GreenVaildSig/TallyNet_v1/README.md

# TallyNet_v1
Archive of my final exam piece TallyNet in version 1. This version contains many beginner errors and is not suitable for production. Hopfully all errors are eliminated in the new Version. All Texts are in German.
