GreenVaildSig/TallyNet_v1/Gehäuse/ne8fdy-c6-4.dxf

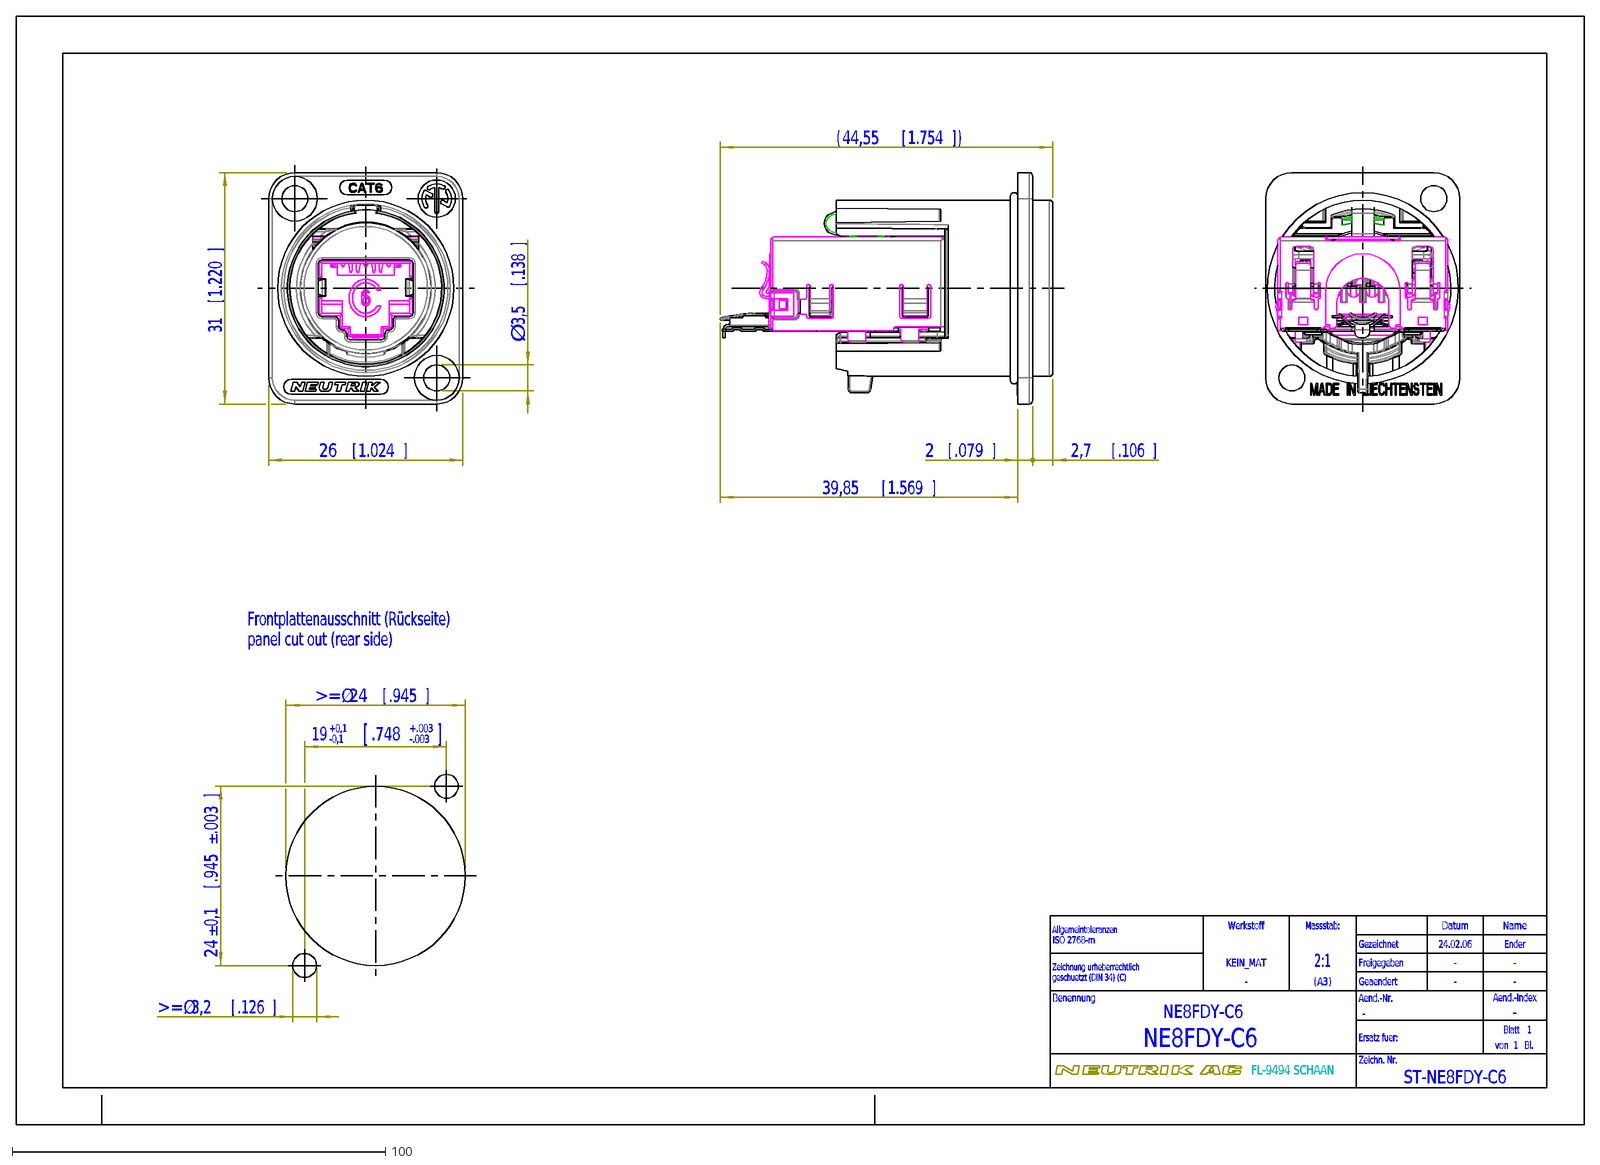
[picture p24: CAD file, 2022-08-05]
Gehäuse/ne8fdy-c6-4.dxf
FL-9494 SCHAAN
19
+0,1
-0,1
.748
+.003
-.003
[
]
24
±
0,1
.945
.003
>=Ø
3,2
.126
26
1.024
31
1.220
2,7
.106
2
.079
(
)
44,55
1.754
Ø
3,5
.138
39,85
1.569
Allgemeintoleranzen
ISO 2768-m
Werkstoff
Massstab:
Datum
Name
Gezeichnet
24.02.06
Ender
Zeichnung urheberrechtlich
geschuetzt (DIN 34) (C)
KEIN_MAT
2:1
Freigegeben
-
A3
Geaendert
Benennung
Aend.-Nr.
Aend.-Index
NE8FDY-C6
Ersatz fuer:
Blatt
1
von
Bl.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
