GreenVaildSig/TallyNet_v1/Gehäuse/nc3fdm3-l-1-4.dxf

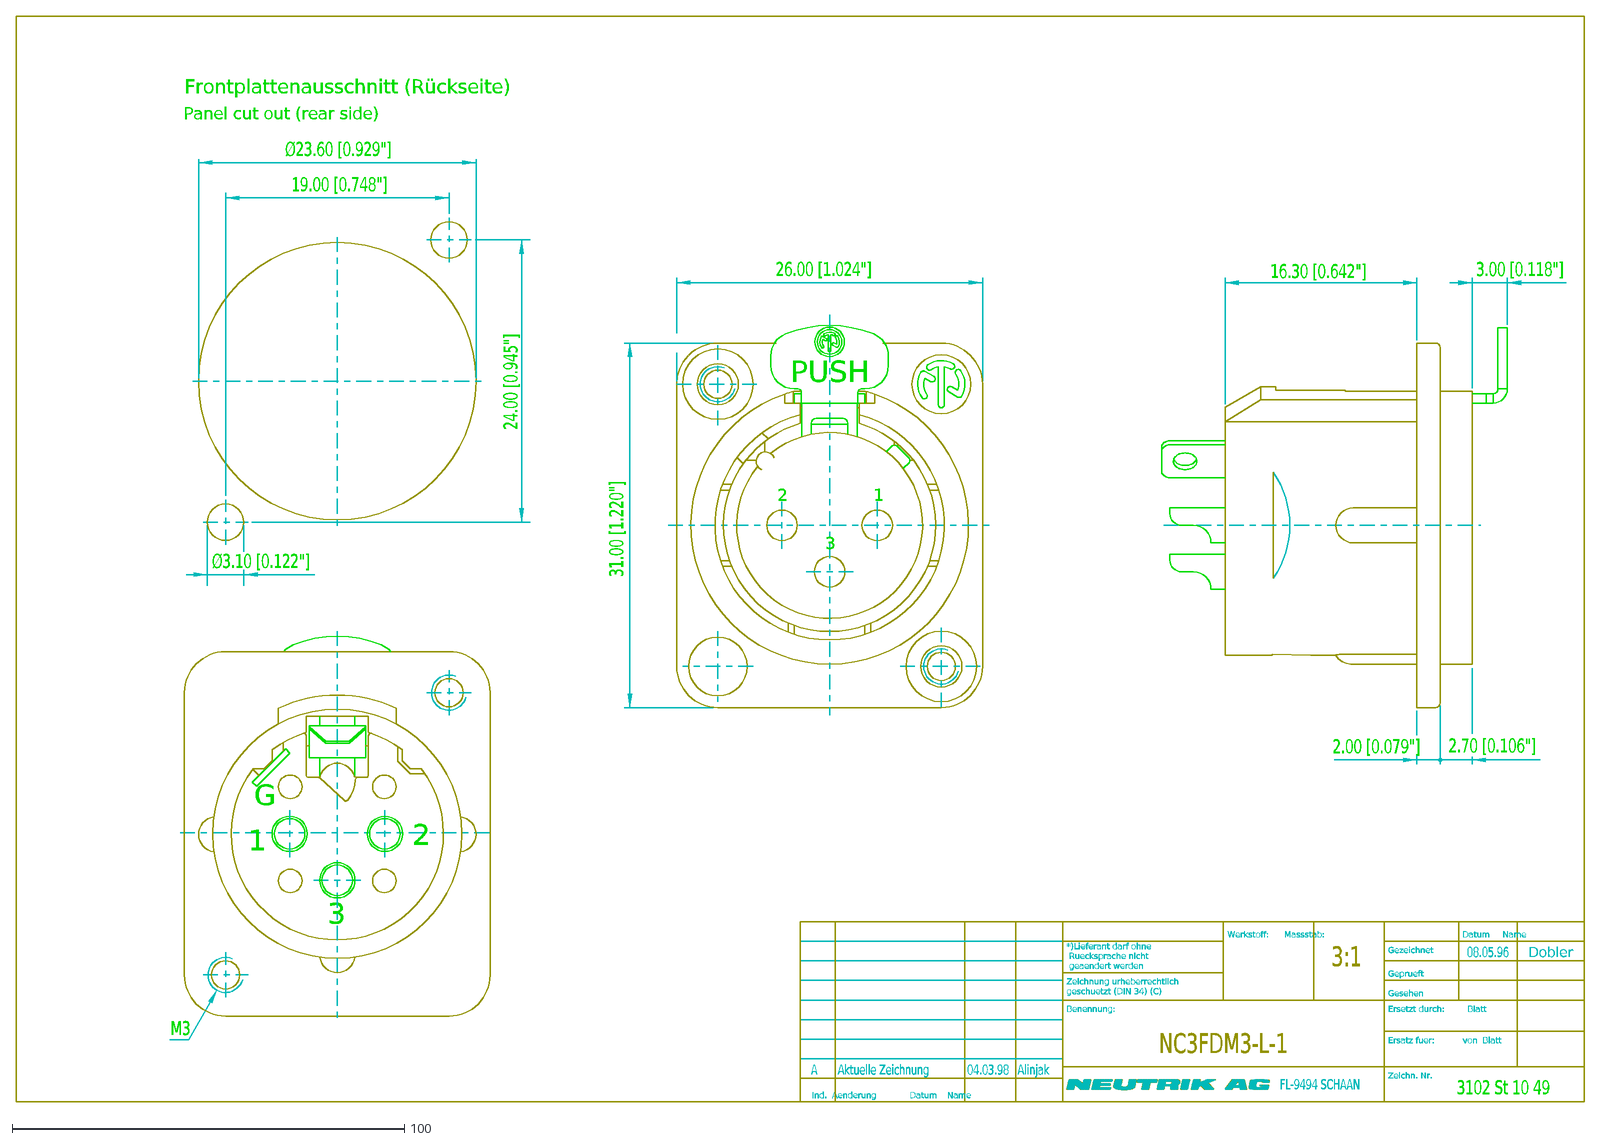
[picture p25: CAD file, 2022-08-05]
Gehäuse/nc3fdm3-l-1-4.dxf
PUSH
Dobler
08.05.96
NC3FDM3-L-1
3102 St 10 49
3:1
A
Aktuelle Zeichnung
04.03.98
Alinjak
Zeichn. Nr.
Ersetzt durch: Blatt
Gezeichnet
Gesehen
Datum Name
Werkstoff: Massstab:
Benennung:
*)Lieferant darf ohne
Ruecksprache nicht
geaendert werden
Zeichnung urheberrechtlich
geschuetzt (DIN 34) (C)
Geprueft
Ersatz fuer: von Blatt
Ind. Aenderung Datum Name
FL-9494 SCHAAN
26.00 [1.024"]
Ø3.10 [0.122"]
31.00 [1.220"]
M3
1
G
3
2
Frontplattenausschnitt (Rückseite)
Panel cut out (rear side)
24.00 [0.945"]
Ø23.60 [0.929"]
19.00 [0.748"]
2.00 [0.079"]
2.70 [0.106"]
16.30 [0.642"]
3.00 [0.118"]
