GreenVaildSig/TallyNet_v1/Gehäuse/#MuxFront.dxf

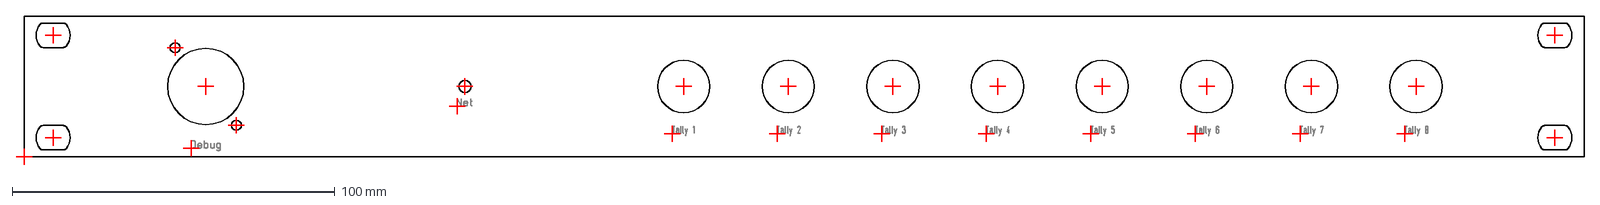
[picture p26: CAD file, 2022-08-05]
Gehäuse/#MuxFront.dxf
485.5 x 46.1 mm
