GreenVaildSig/TallyNet_v1/Gehäuse/#DeMuxFront.dxf

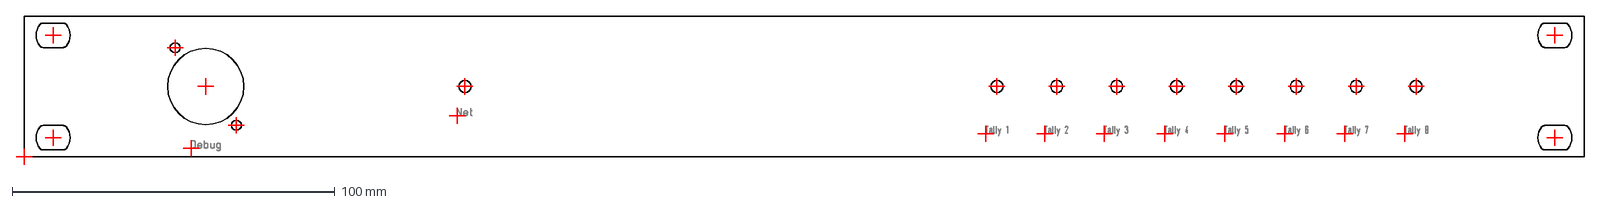
[picture p27: CAD file, 2022-08-05]
Gehäuse/#DeMuxFront.dxf
485.5 x 46.1 mm
