GreenVaildSig/TallyNet_v1/Gehäuse/#Back.dxf

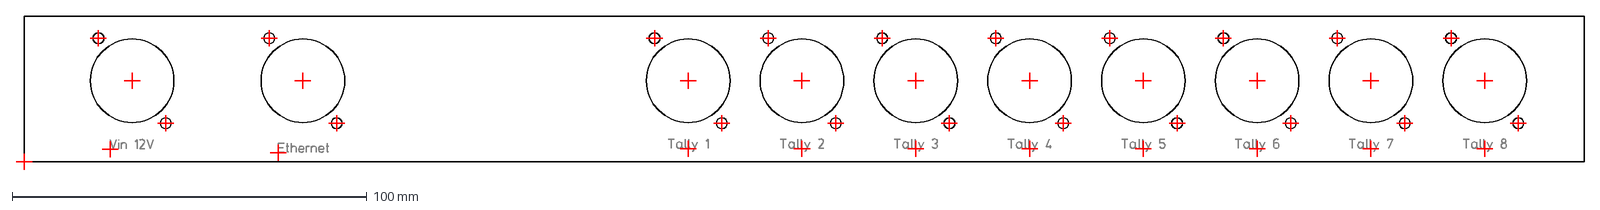
[picture p28: CAD file, 2022-08-05]
Gehäuse/#Back.dxf
442.3 x 43.3 mm
