GreenVaildSig/TallyNet_v1/(list of files, cad)

Other CAD files:
Gehäuse/Back.dxf
Gehäuse/DeMuxFront.dxf
Gehäuse/MuxFront.dxf
