GreenVaildSig/TallyNet_v1/02 Anlagen.pdf

J10 USB_B GND A¹ | RX2- A10 RX2+ A11 TX1+ A2 TX1- A3 VBUS | A4 CC1 A5 D+ A6 D- A7 SBU1 | A8 RX1- B10 RX1+ B11 TX2+ B2 TX2- B3 CC2 B5 D+ B6 D- B7 SBU2 | B8 SHIELD S¹
J7 XLR3 ¹ | 2 3 1 | 2 3

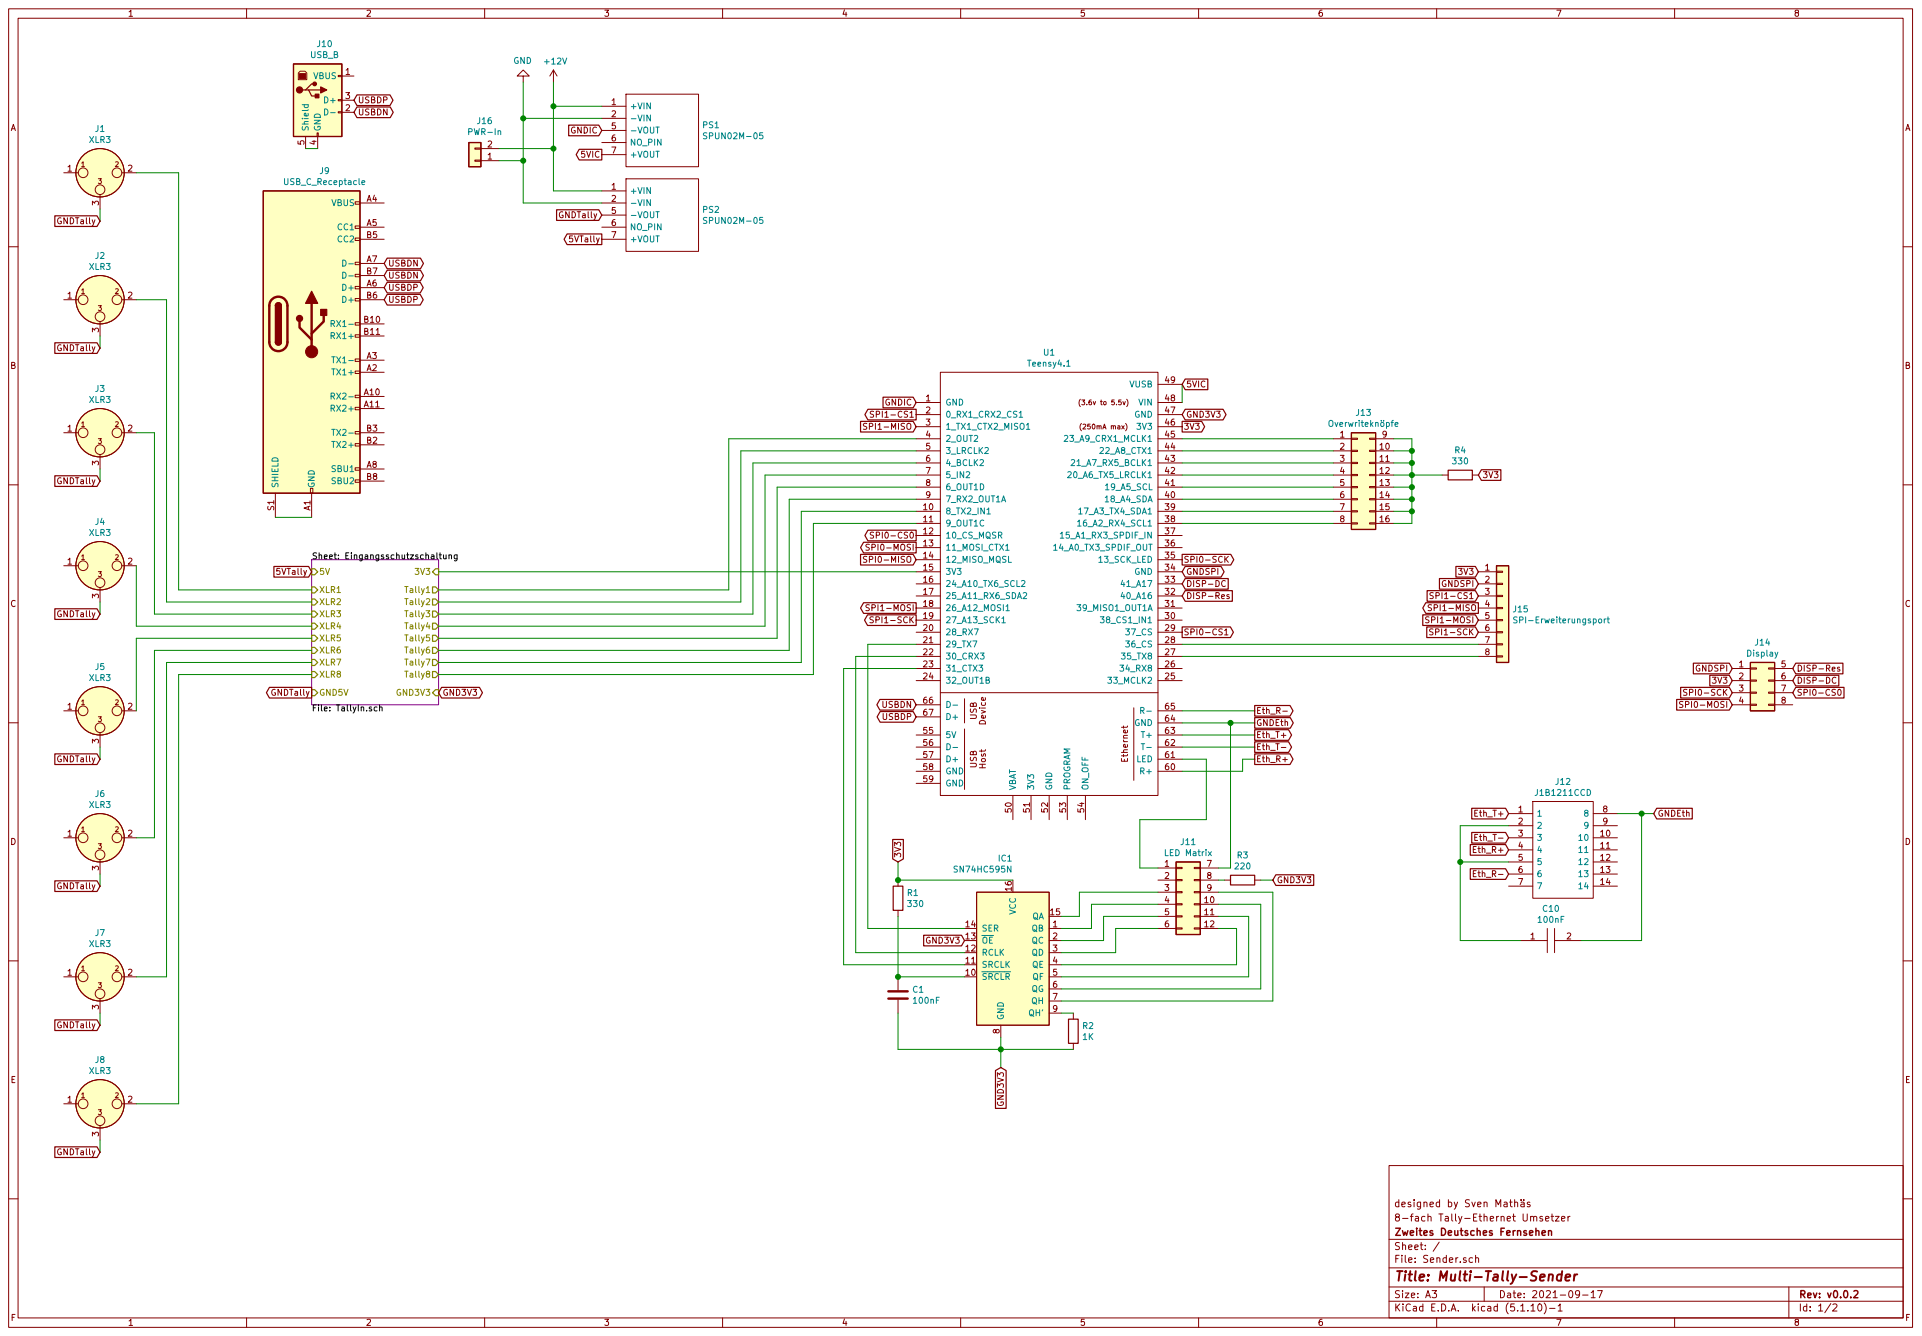
[picture p29: page 1]

designed by Sven Mathäs
8-fach Tally-Ethernet Umsetzer
Id: 1/2 Title: Multi-Tally-Sender File: Sender.sch Sheet: / Zweites Deutsches Fernsehen

Tally1 | GND⁵V GND⁵V | GND⁵V | GND⁵V GND⁵V | GND⁵V
XLR5 | GND⁵V GND⁵V GND⁵V

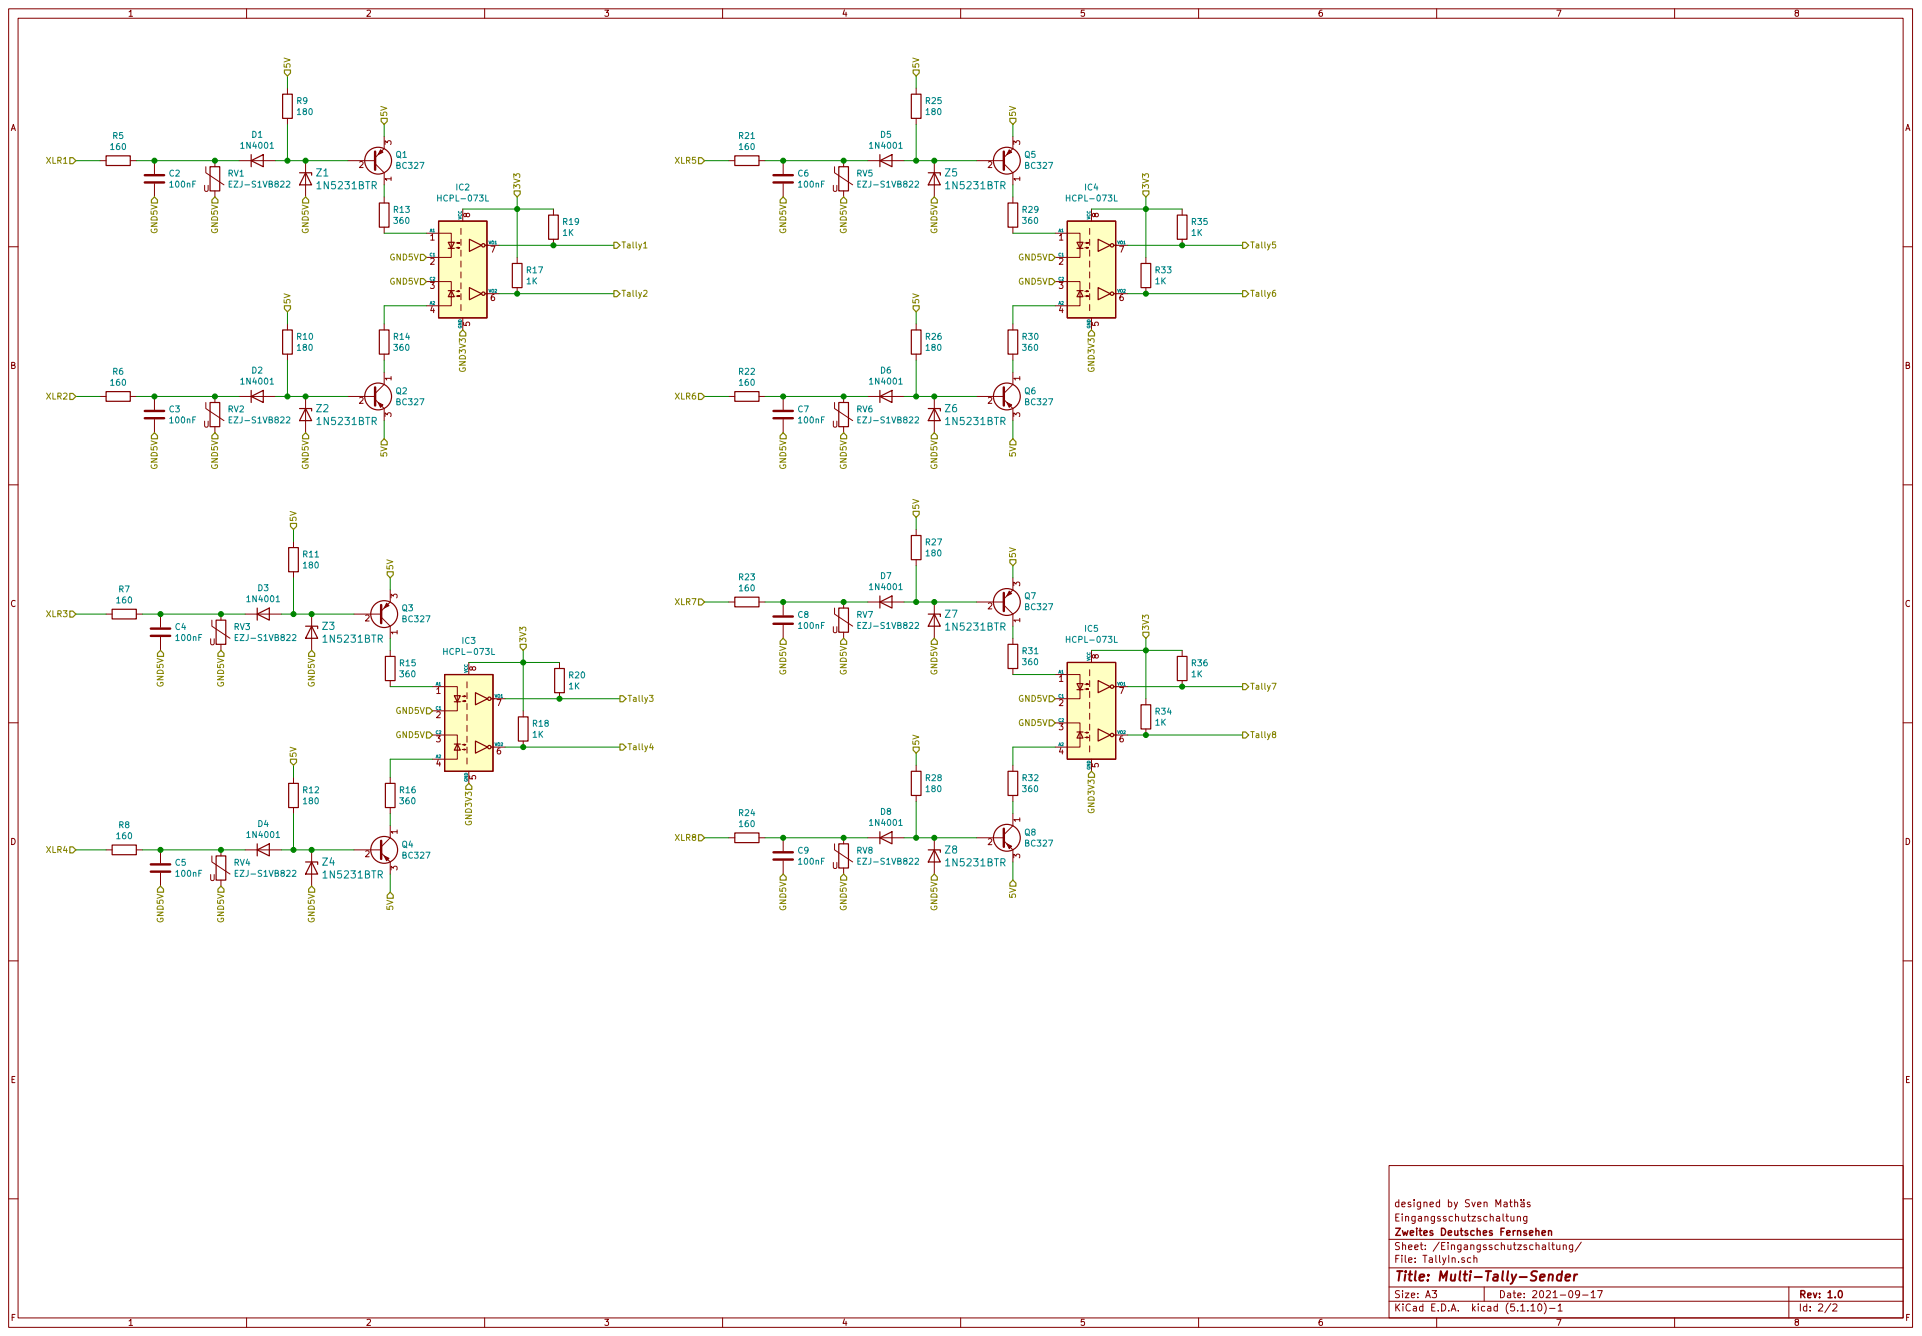
[picture p30: page 2]

designed by Sven Mathäs
Sheet: /Eingangsschutzschaltung/ Zweites Deutsches Fernsehen Eingangsschutzschaltung

File: TallyIn.sch
Id: 2/2 Title: Multi-Tally-Sender

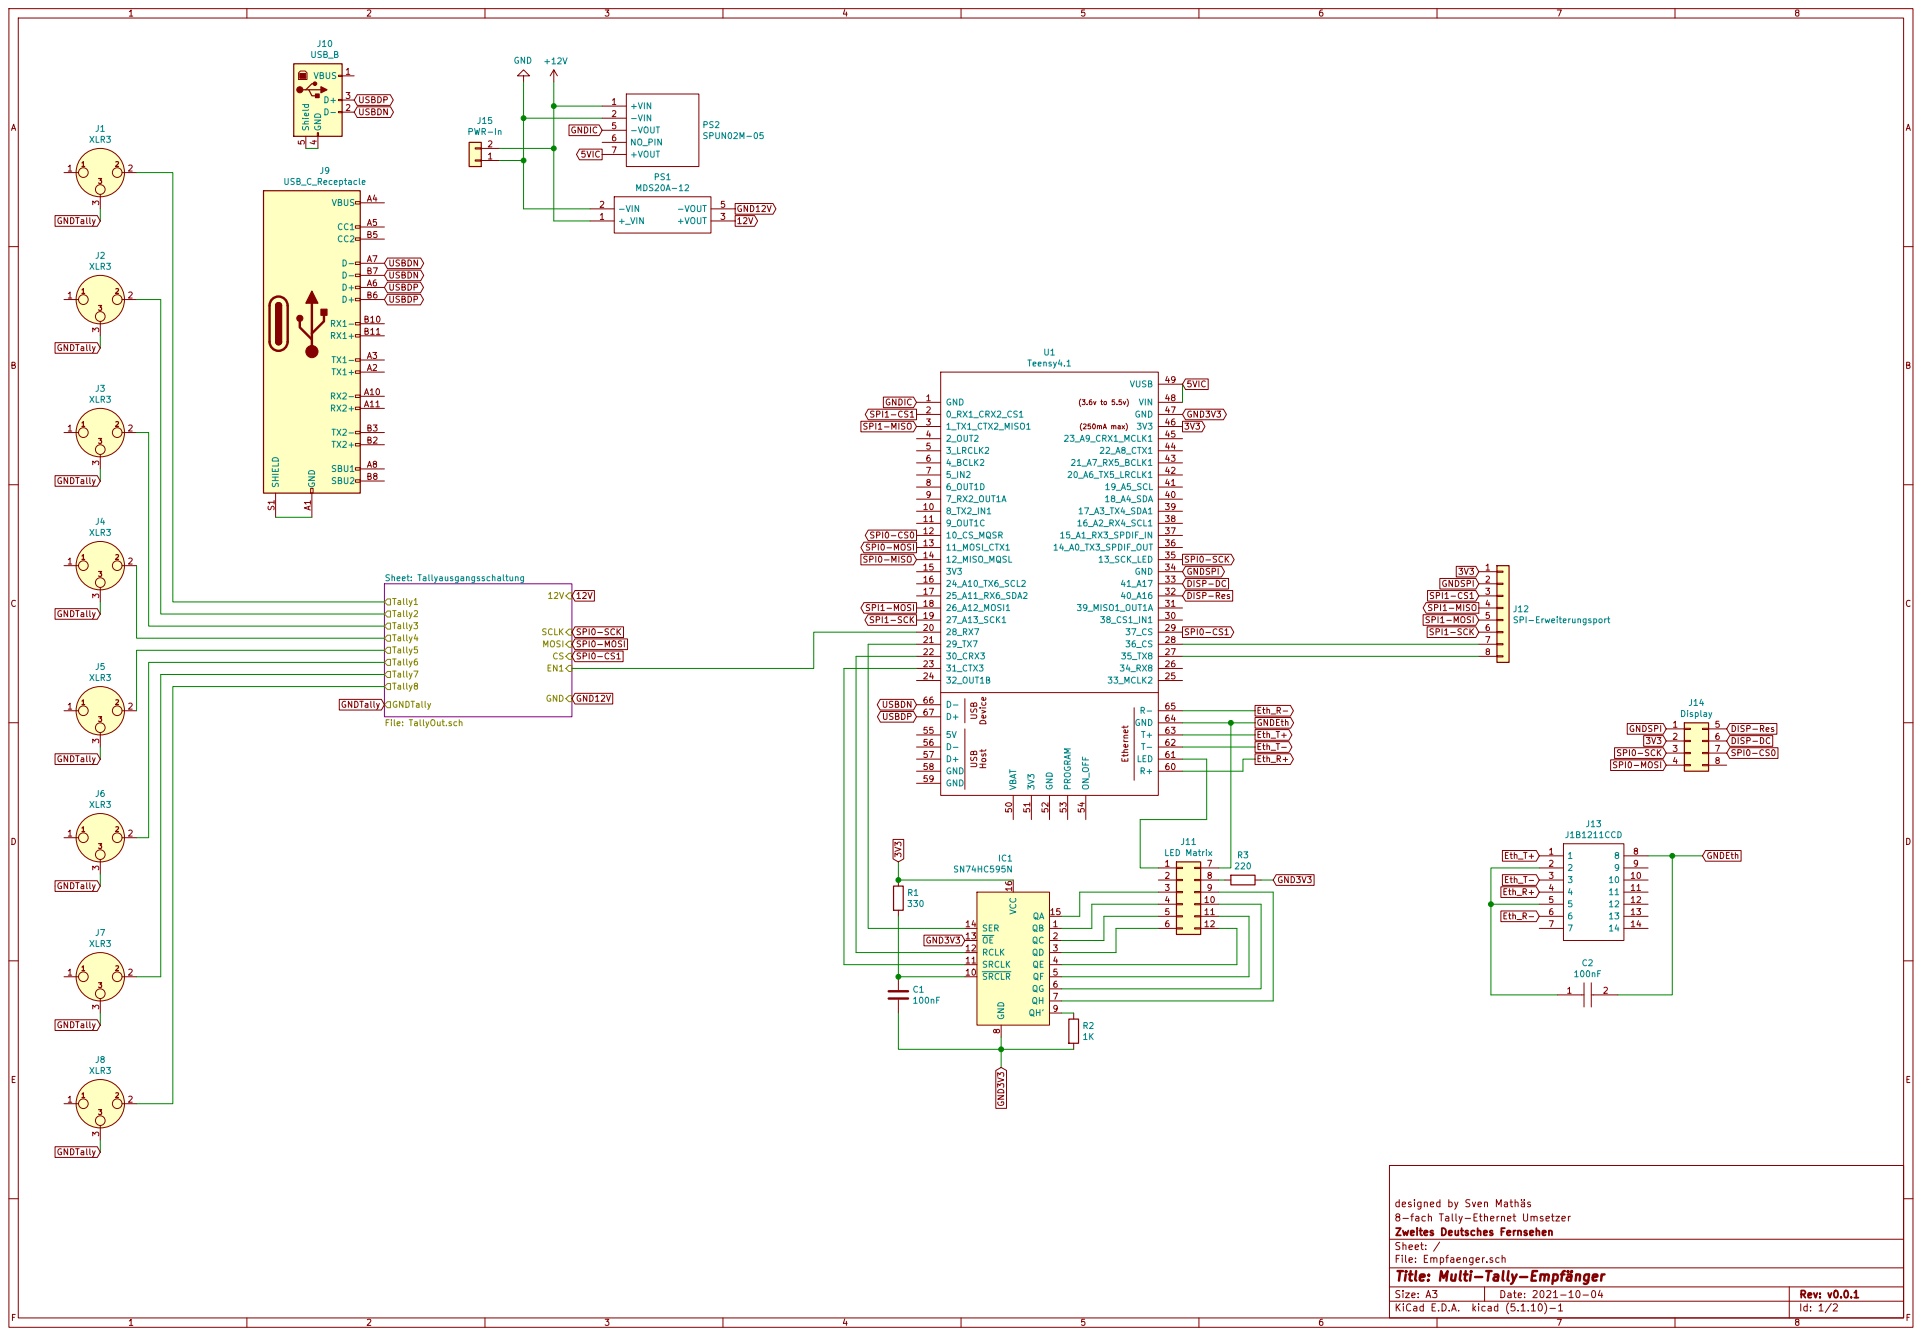
[picture p31: page 3]

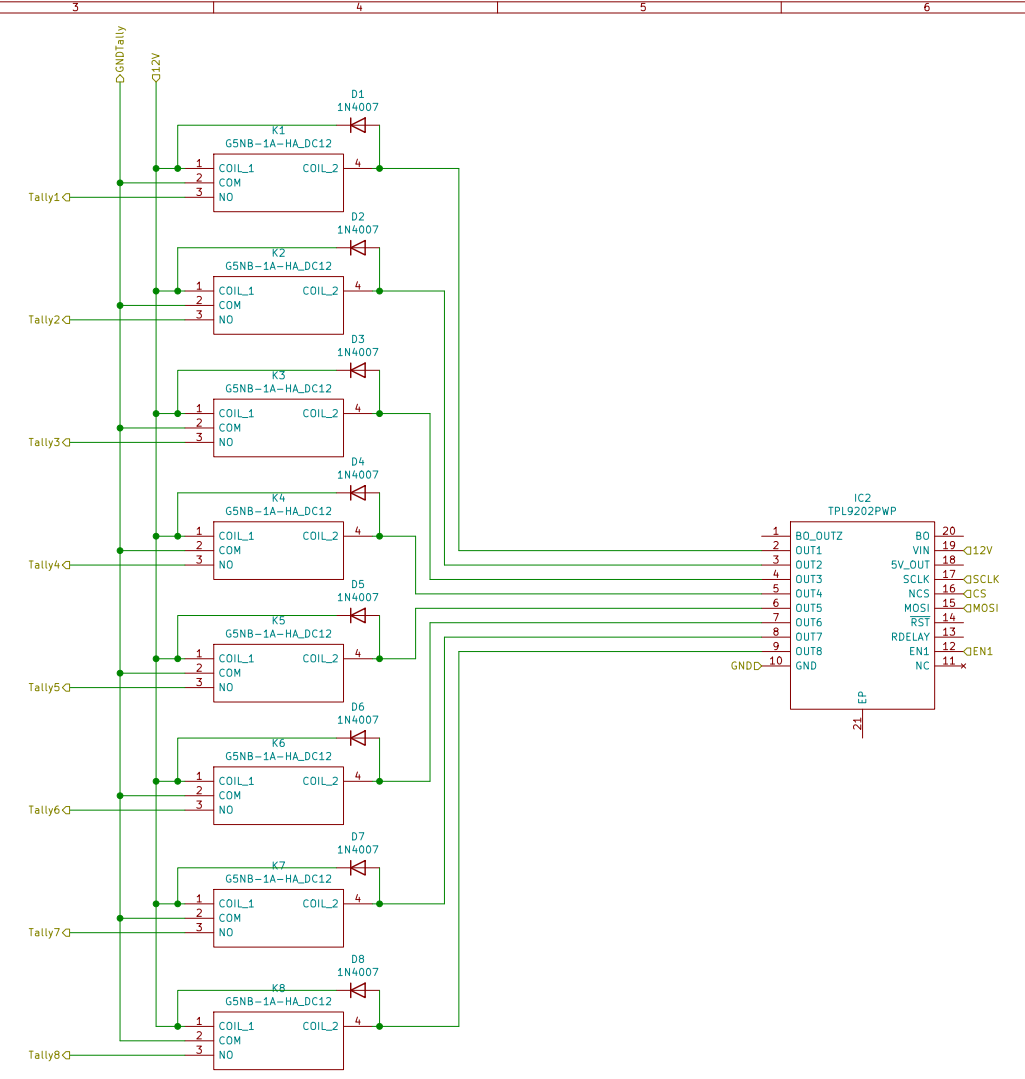
[picture p32: page 4]

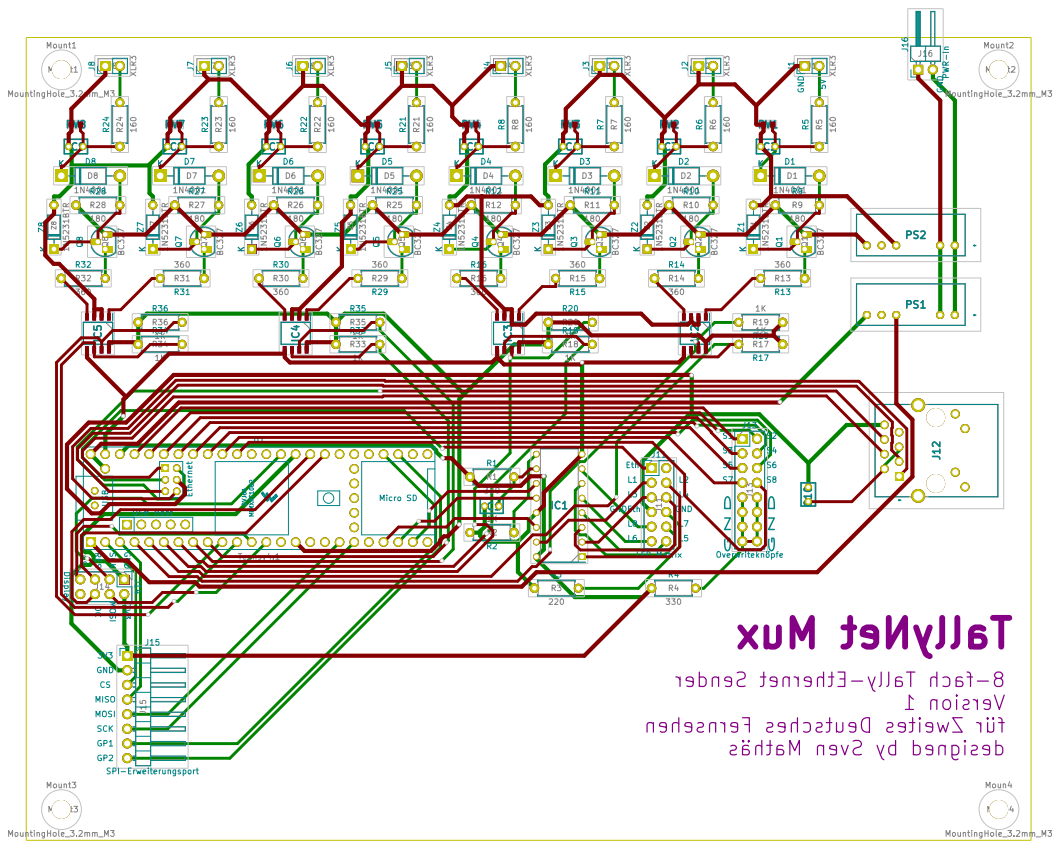
[picture p33: page 5]

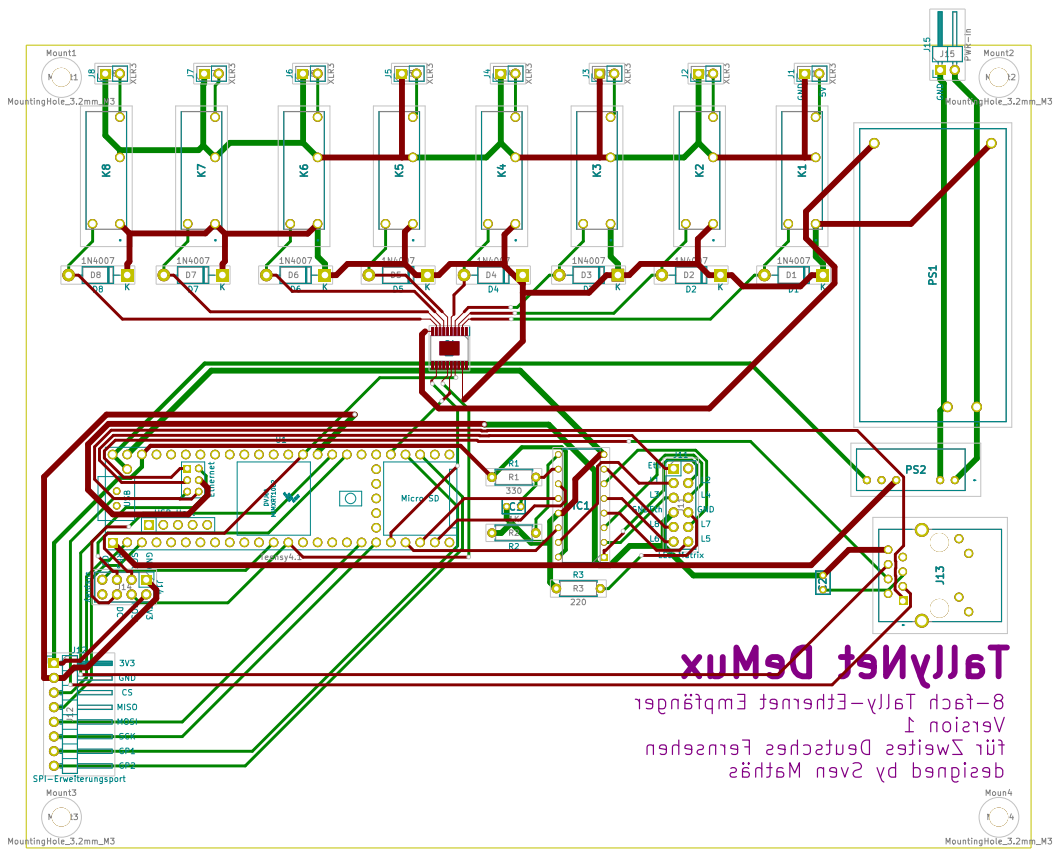
[picture p34: page 6]

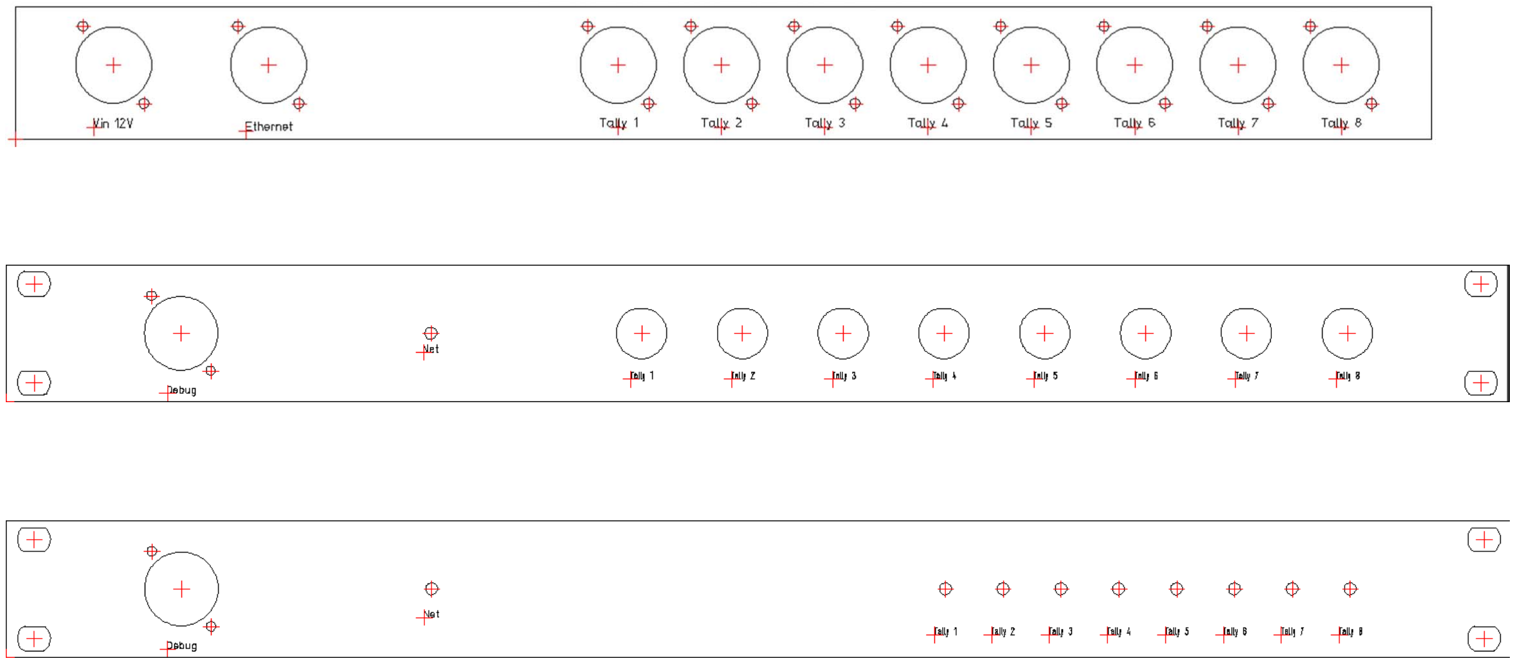
[picture p35: page 7]
