GreenVaildSig/TallyNet_v1/Gehäuse/back1.pdf

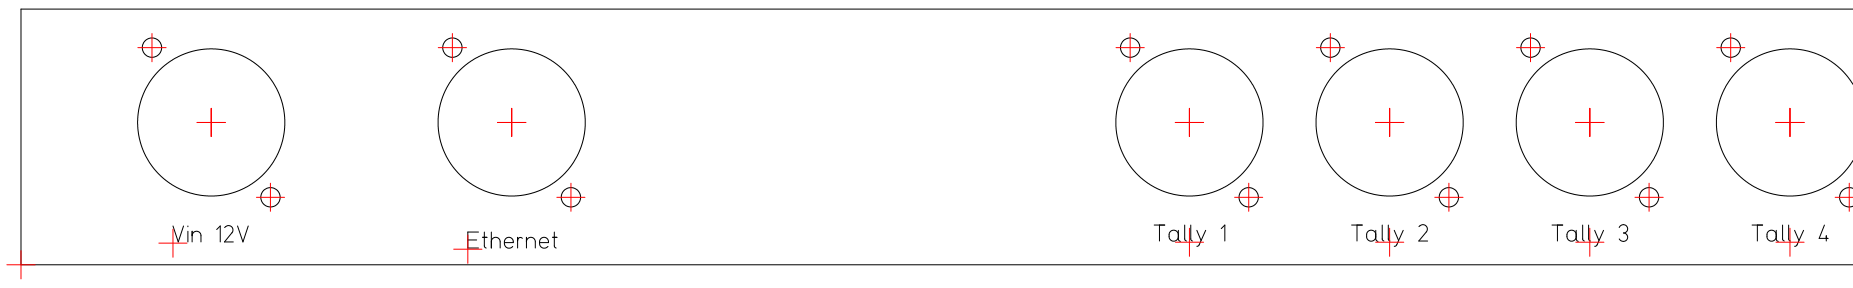
[picture p36: page 1]
