GreenVaildSig/TallyNet_v1/Gehäuse/back2.pdf

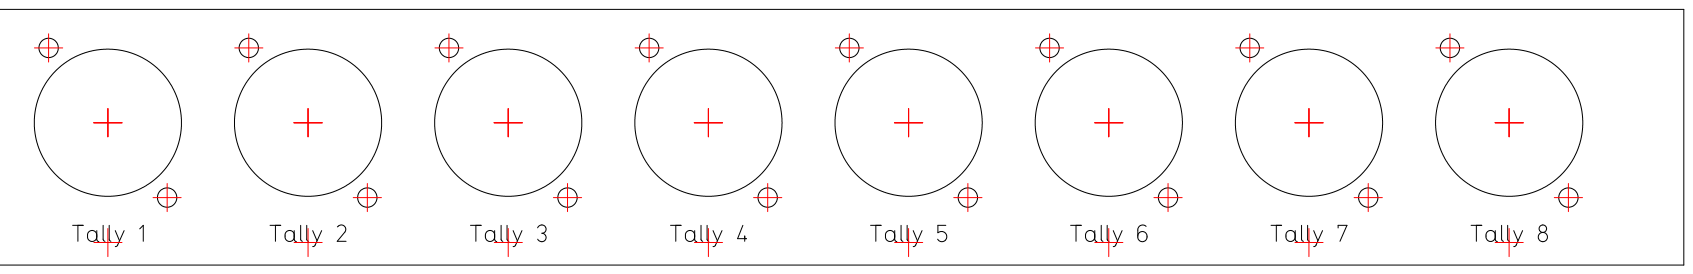
[picture p37: page 1]
