GreenVaildSig/TallyNet_v1/Gehäuse/DeMux1.pdf

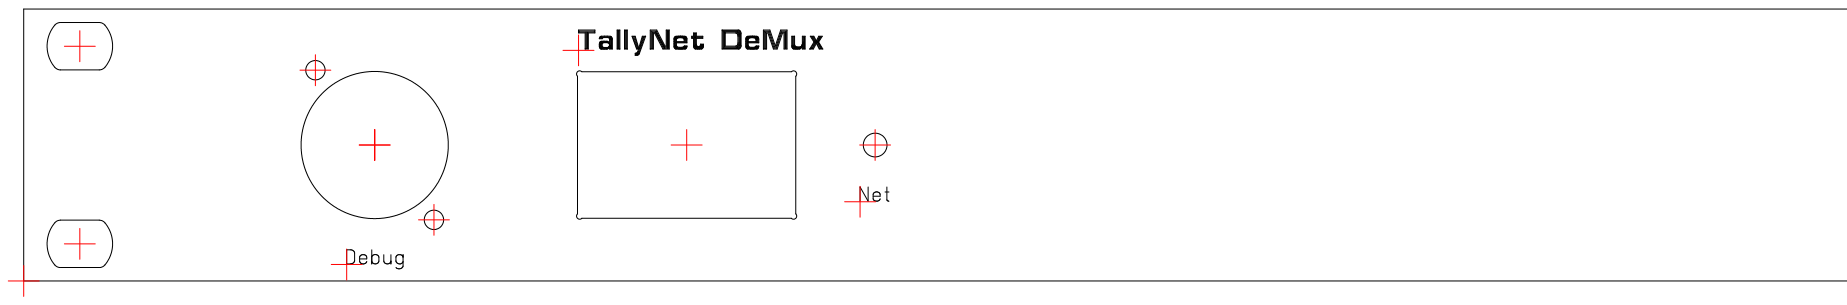
[picture p38: page 1]
