GreenVaildSig/TallyNet_v1/Gehäuse/DeMux2.pdf

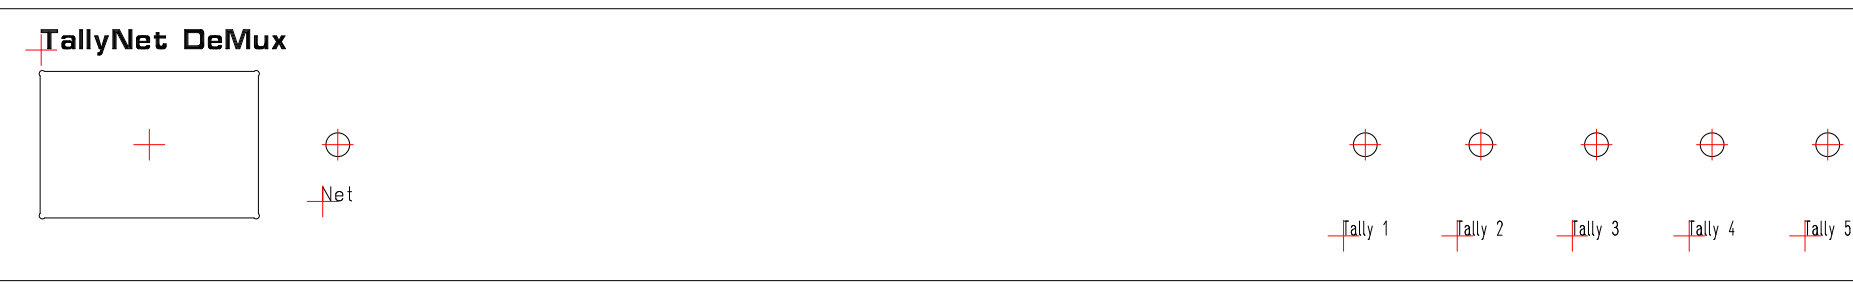
[picture p39: page 1]
