GreenVaildSig/TallyNet_v1/Gehäuse/Mux1.pdf

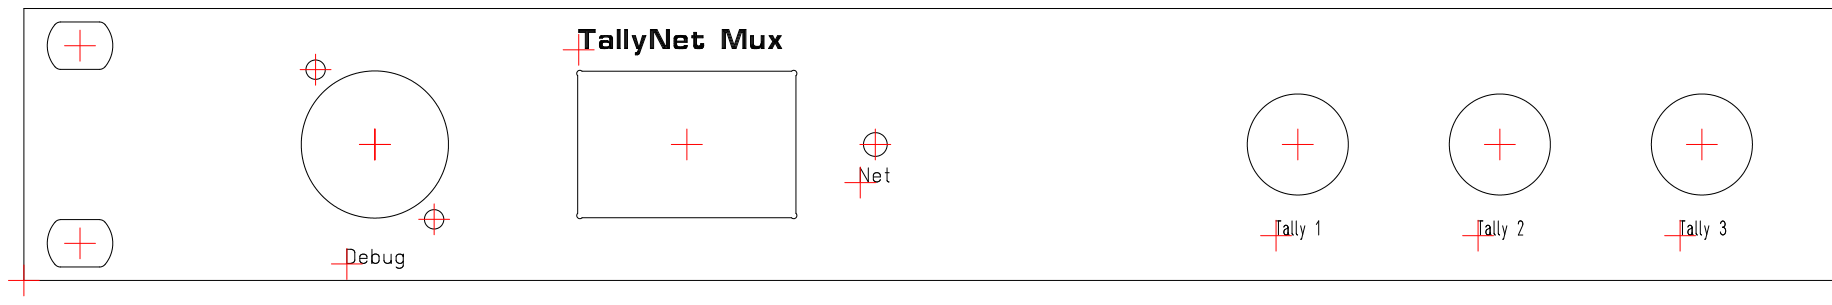
[picture p40: page 1]
