GreenVaildSig/TallyNet_v1/Gehäuse/Mux2.pdf

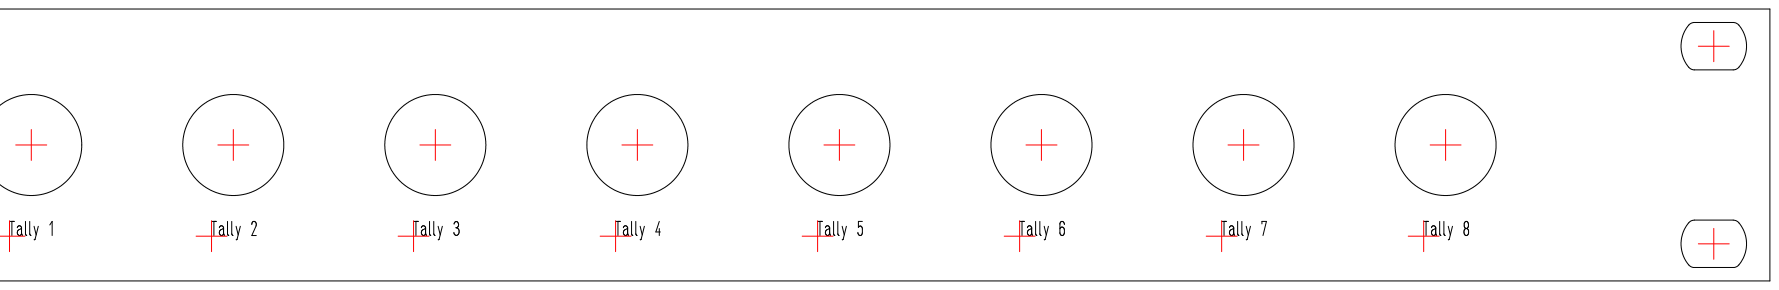
[picture p41: page 1]
