GreenVaildSig/TallyNet_v1/Hardware/Sender/Sender.kicad_pcb

## KiCad design Hardware/Sender/Sender.kicad_pcb (2022-08-05)

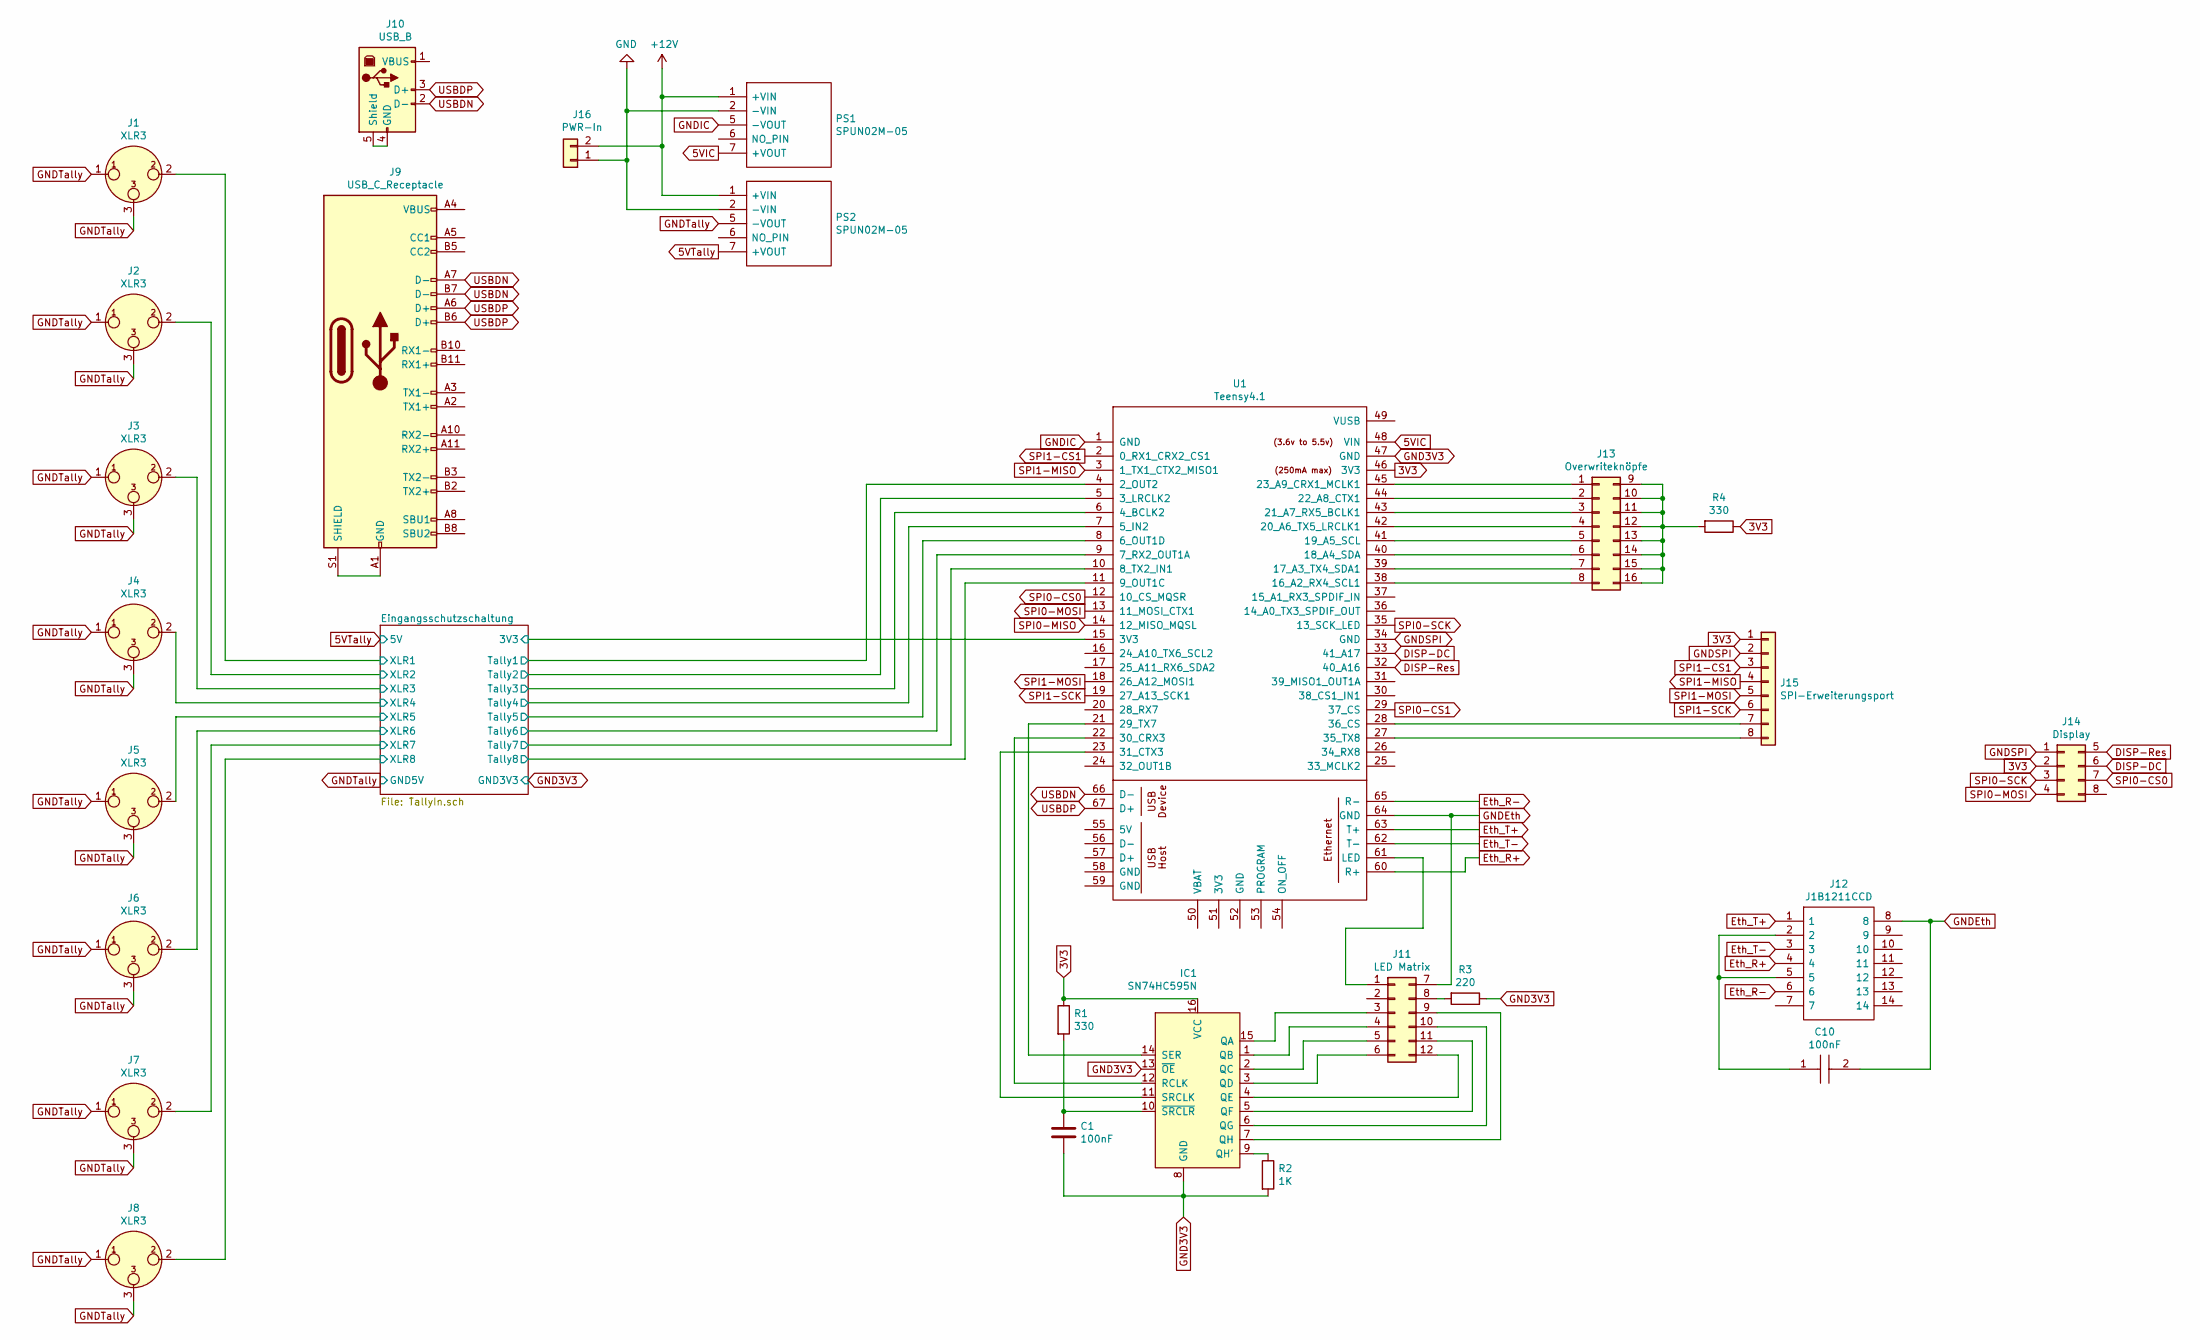
[picture p42: schematic Sender.sch, Multi-Tally-Sender]

Parts:
C1, C10: 100nF; MONO-KAP_SIZE-15-L-5_
IC1: SN74HC595N; DIP794W53P254L1930H508Q16N; Mouser Part Number 595-SN74HC595N
J1, J2, J3, J4, J5, J6, J7, J8: XLR3; PinHeader_1x02_P2.54mm_Vertical
J9: USB_C_Receptacle
J10: USB_B
J11: LED Matrix; PinHeader_2x06_P2.54mm_Vertical
J12: J1B1211CCD; Mouser Part Number 950-J1B1211CCD
J13: Overwriteknöpfe; PinHeader_2x08_P2.54mm_Vertical
J14: Display; PinHeader_2x04_P2.54mm_Vertical
J15: SPI-Erweiterungsport; PinHeader_1x08_P2.54mm_Horizontal
J16: PWR-In; PinHeader_1x02_P2.54mm_Horizontal
PS1, PS2: SPUN02M-05; SPUN02M05; Mouser Part Number 709-SPUN02M-05
R1, R4: 330; R_Axial_DIN0207_L6.3mm_D2.5mm_P7.62mm_Horizontal
R2: 1K; R_Axial_DIN0207_L6.3mm_D2.5mm_P7.62mm_Horizontal
R3: 220; R_Axial_DIN0207_L6.3mm_D2.5mm_P7.62mm_Horizontal
U1: Teensy4.1; Teensy41

Connections:
3V3: IC1.16 (VCC), J14.2, J15.1, R1.1, R4.1, U1.46 (3V3)
5VIC: PS1.7 (+VOUT), U1.48 (VIN), U1.49 (VUSB)
5VTally: PS2.7 (+VOUT); also elsewhere on the board
+12V: J16.2, PS1.1 (+VIN), PS2.1 (+VIN)
/Eingangsschutzschaltung/3V3: U1.15 (3V3); also elsewhere on the board
/Eingangsschutzschaltung/Tally1: U1.4 (2_OUT2); also elsewhere on the board
/Eingangsschutzschaltung/Tally2: U1.5 (3_LRCLK2); also elsewhere on the board
/Eingangsschutzschaltung/Tally3: U1.6 (4_BCLK2); also elsewhere on the board
/Eingangsschutzschaltung/Tally4: U1.7 (5_IN2); also elsewhere on the board
/Eingangsschutzschaltung/Tally5: U1.8 (6_OUT1D); also elsewhere on the board
/Eingangsschutzschaltung/Tally6: U1.9 (7_RX2_OUT1A); also elsewhere on the board
/Eingangsschutzschaltung/Tally7: U1.10 (8_TX2_IN1); also elsewhere on the board
/Eingangsschutzschaltung/Tally8: U1.11 (9_OUT1C); also elsewhere on the board
/Eingangsschutzschaltung/XLR1: J1.2; also elsewhere on the board
/Eingangsschutzschaltung/XLR2: J2.2; also elsewhere on the board
/Eingangsschutzschaltung/XLR3: J3.2; also elsewhere on the board
/Eingangsschutzschaltung/XLR4: J4.2; also elsewhere on the board
/Eingangsschutzschaltung/XLR5: J5.2; also elsewhere on the board
/Eingangsschutzschaltung/XLR6: J6.2; also elsewhere on the board
/Eingangsschutzschaltung/XLR7: J7.2; also elsewhere on the board
/Eingangsschutzschaltung/XLR8: J8.2; also elsewhere on the board
DISP-DC: J14.6, U1.33 (41_A17)
DISP-Res: J14.5, U1.32 (40_A16)
Eth_R+: J12.4, U1.60 (R+)
Eth_R-: J12.6, U1.65 (R-)
Eth_T+: J12.1, U1.63 (T+)
Eth_T-: J12.3, U1.62 (T-)
GND: J16.1, PS1.2 (-VIN), PS2.2 (-VIN)
GND3V3: C1.2, IC1.8 (GND), IC1.13 (~OE), R2.2, R3.1, U1.47 (GND); also elsewhere on the board
GNDEth: C10.2, J11.7, J12.8, U1.64 (GND)
GNDIC: PS1.5 (-VOUT), U1.1 (GND)
GNDSPI: J14.1, J15.2, U1.34 (GND)
GNDTally: J1.1, J1.3, J2.1, J2.3, J3.1, J3.3, J4.1, J4.3, J5.1, J5.3, J6.1, J6.3, J7.1, J7.3, J8.1, J8.3, PS2.5 (-VOUT); also elsewhere on the board
unnamed: C1.1, IC1.10 (~SRCLR), R1.2
unnamed: C10.1, J12.2, J12.5
unnamed: IC1.1 (QB), J11.4
unnamed: IC1.2 (QC), J11.5
unnamed: IC1.3 (QD), J11.6
unnamed: IC1.4 (QE), J11.12
unnamed: IC1.5 (QF), J11.11
unnamed: IC1.6 (QG), J11.10
unnamed: IC1.7 (QH), J11.9
unnamed: IC1.9 (QH'), R2.1
unnamed: IC1.11 (SRCLK), U1.23 (31_CTX3)
unnamed: IC1.12 (RCLK), U1.22 (30_CRX3)
unnamed: IC1.14 (SER), U1.21 (29_TX7)
unnamed: IC1.15 (QA), J11.3
unnamed: J9.A1 (GND), J9.A12 (GND), J9.B1 (GND), J9.B12 (GND), J9.S1 (SHIELD)
unnamed: J9.A4 (VBUS), J9.A9 (VBUS), J9.B4 (VBUS), J9.B9 (VBUS)
unnamed: J10.4 (GND), J10.5 (Shield)
unnamed: J11.1, U1.61 (LED)
unnamed: J11.8, R3.2
unnamed: J13.1, U1.45 (23_A9_CRX1_MCLK1)
unnamed: J13.2, U1.44 (22_A8_CTX1)
unnamed: J13.3, U1.43 (21_A7_RX5_BCLK1)
unnamed: J13.4, U1.42 (20_A6_TX5_LRCLK1)
unnamed: J13.5, U1.41 (19_A5_SCL)
unnamed: J13.6, U1.40 (18_A4_SDA)
unnamed: J13.7, U1.39 (17_A3_TX4_SDA1)
unnamed: J13.8, U1.38 (16_A2_RX4_SCL1)
unnamed: J13.9, J13.10, J13.11, J13.12, J13.13, J13.14, J13.15, J13.16, R4.2
unnamed: J15.7, U1.28 (36_CS)
unnamed: J15.8, U1.27 (35_TX8)
SPI0-CS0: J14.7, U1.12 (10_CS_MQSR)
SPI0-CS1: U1.29 (37_CS)
SPI0-MISO: U1.14 (12_MISO_MQSL)
SPI0-MOSI: J14.4, U1.13 (11_MOSI_CTX1)
SPI0-SCK: J14.3, U1.35 (13_SCK_LED)
SPI1-CS1: J15.3, U1.2 (0_RX1_CRX2_CS1)
SPI1-MISO: J15.4, U1.3 (1_TX1_CTX2_MISO1)
SPI1-MOSI: J15.5, U1.18 (26_A12_MOSI1)
SPI1-SCK: J15.6, U1.19 (27_A13_SCK1)
USBDN: J9.A7 (D-), J9.B7 (D-), J10.2 (D-), U1.66 (D-)
USBDP: J9.A6 (D+), J9.B6 (D+), J10.3 (D+), U1.67 (D+)

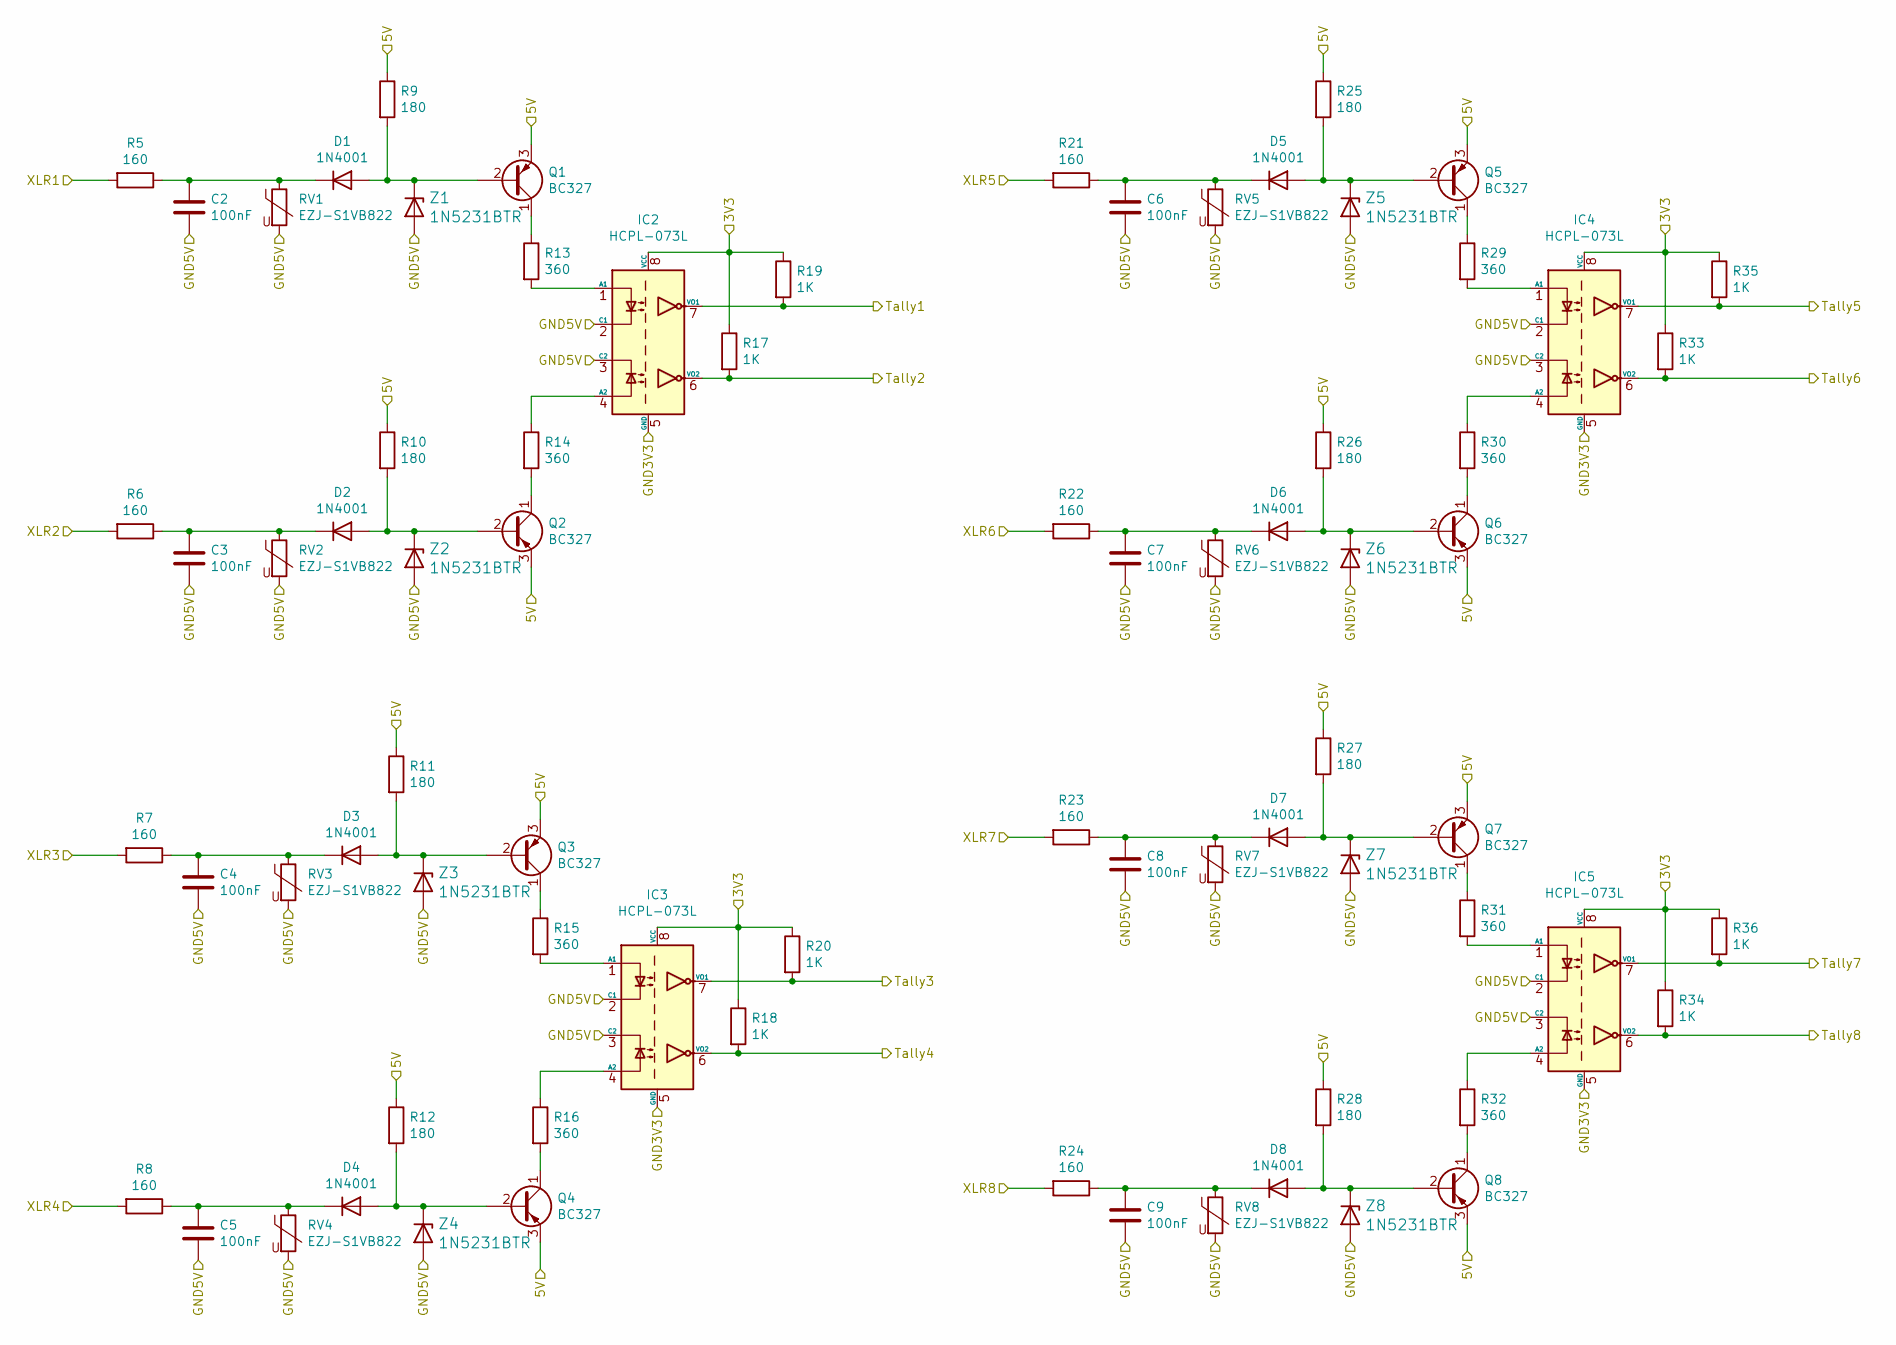
[picture p43: schematic TallyIn.sch, Multi-Tally-Sender]

Parts:
C2, C3, C4, C5, C6, C7, C8, C9: 100nF; MONO-KAP_SIZE-15-L-5_
D1, D2, D3, D4, D5, D6, D7, D8: 1N4001; D_DO-41_SOD81_P10.16mm_Horizontal
IC2, IC3, IC4, IC5: HCPL-073L; SOIC127P599X361-8N; Mouser Part Number 630-HCPL-073L
Q1, Q2, Q3, Q4, Q5, Q6, Q7, Q8: BC327; TO-92_HandSolder
R5, R6, R7, R8, R21, R22, R23, R24: 160; R_Axial_DIN0207_L6.3mm_D2.5mm_P7.62mm_Horizontal
R9, R10, R11, R12, R25, R26, R27, R28: 180; R_Axial_DIN0207_L6.3mm_D2.5mm_P7.62mm_Horizontal
R13, R14, R15, R16, R29, R30, R31, R32: 360; R_Axial_DIN0207_L6.3mm_D2.5mm_P7.62mm_Horizontal
R17, R18, R19, R20, R33, R34, R35, R36: 1K; R_Axial_DIN0207_L6.3mm_D2.5mm_P7.62mm_Horizontal
RV1, RV2, RV3, RV4, RV5, RV6, RV7, RV8: EZJ-S1VB822; VARC1608X90N; Mouser Part Number 667-EZJ-S1VB822
Z1, Z2, Z3, Z4, Z5, Z6, Z7, Z8: 1N5231BTR; D_DO-35_SOD27_P7.62mm_Horizontal; MPN 1N5231BTR; Digi-Key_PN 1N5231BFSCT-ND

Connections:
5VTally: Q1.3 (E), Q2.3 (E), Q3.3 (E), Q4.3 (E), Q5.3 (E), Q6.3 (E), Q7.3 (E), Q8.3 (E), R9.1, R10.1, R11.1, R12.1, R25.1, R26.1, R27.1, R28.1; also elsewhere on the board
/Eingangsschutzschaltung/3V3: IC2.8 (VCC), IC3.8 (VCC), IC4.8 (VCC), IC5.8 (VCC), R17.1, R18.1, R19.1, R20.1, R33.1, R34.1, R35.1, R36.1; also elsewhere on the board
/Eingangsschutzschaltung/Tally1: IC2.7 (VO1), R19.2; also elsewhere on the board
/Eingangsschutzschaltung/Tally2: IC2.6 (VO2), R17.2; also elsewhere on the board
/Eingangsschutzschaltung/Tally3: IC3.7 (VO1), R20.2; also elsewhere on the board
/Eingangsschutzschaltung/Tally4: IC3.6 (VO2), R18.2; also elsewhere on the board
/Eingangsschutzschaltung/Tally5: IC4.7 (VO1), R35.2; also elsewhere on the board
/Eingangsschutzschaltung/Tally6: IC4.6 (VO2), R33.2; also elsewhere on the board
/Eingangsschutzschaltung/Tally7: IC5.7 (VO1), R36.2; also elsewhere on the board
/Eingangsschutzschaltung/Tally8: IC5.6 (VO2), R34.2; also elsewhere on the board
/Eingangsschutzschaltung/XLR1: R5.2; also elsewhere on the board
/Eingangsschutzschaltung/XLR2: R6.2; also elsewhere on the board
/Eingangsschutzschaltung/XLR3: R7.2; also elsewhere on the board
/Eingangsschutzschaltung/XLR4: R8.2; also elsewhere on the board
/Eingangsschutzschaltung/XLR5: R21.2; also elsewhere on the board
/Eingangsschutzschaltung/XLR6: R22.2; also elsewhere on the board
/Eingangsschutzschaltung/XLR7: R23.2; also elsewhere on the board
/Eingangsschutzschaltung/XLR8: R24.2; also elsewhere on the board
GND3V3: IC2.5 (GND), IC3.5 (GND), IC4.5 (GND), IC5.5 (GND); also elsewhere on the board
GNDTally: C2.2, C3.2, C4.2, C5.2, C6.2, C7.2, C8.2, C9.2, IC2.2 (C1), IC2.3 (C2), IC3.2 (C1), IC3.3 (C2), IC4.2 (C1), IC4.3 (C2), IC5.2 (C1), IC5.3 (C2), RV1.2, RV2.2, RV3.2, RV4.2, RV5.2, RV6.2, RV7.2, RV8.2, Z1.2 (A), Z2.2 (A), Z3.2 (A), Z4.2 (A), Z5.2 (A), Z6.2 (A), Z7.2 (A), Z8.2 (A); also elsewhere on the board
unnamed: C2.1, D1.1 (K), R5.1, RV1.1
unnamed: C3.1, D2.1 (K), R6.1, RV2.1
unnamed: C4.1, D3.1 (K), R7.1, RV3.1
unnamed: C5.1, D4.1 (K), R8.1, RV4.1
unnamed: C6.1, D5.1 (K), R21.1, RV5.1
unnamed: C7.1, D6.1 (K), R22.1, RV6.1
unnamed: C8.1, D7.1 (K), R23.1, RV7.1
unnamed: C9.1, D8.1 (K), R24.1, RV8.1
unnamed: D1.2 (A), Q1.2 (B), R9.2, Z1.1 (K)
unnamed: D2.2 (A), Q2.2 (B), R10.2, Z2.1 (K)
unnamed: D3.2 (A), Q3.2 (B), R11.2, Z3.1 (K)
unnamed: D4.2 (A), Q4.2 (B), R12.2, Z4.1 (K)
unnamed: D5.2 (A), Q5.2 (B), R25.2, Z5.1 (K)
unnamed: D6.2 (A), Q6.2 (B), R26.2, Z6.1 (K)
unnamed: D7.2 (A), Q7.2 (B), R27.2, Z7.1 (K)
unnamed: D8.2 (A), Q8.2 (B), R28.2, Z8.1 (K)
unnamed: IC2.1 (A1), R13.2
unnamed: IC2.4 (A2), R14.1
unnamed: IC3.1 (A1), R15.2
unnamed: IC3.4 (A2), R16.1
unnamed: IC4.1 (A1), R29.2
unnamed: IC4.4 (A2), R30.1
unnamed: IC5.1 (A1), R31.2
unnamed: IC5.4 (A2), R32.1
unnamed: Q1.1 (C), R13.1
unnamed: Q2.1 (C), R14.2
unnamed: Q3.1 (C), R15.1
unnamed: Q4.1 (C), R16.2
unnamed: Q5.1 (C), R29.1
unnamed: Q6.1 (C), R30.2
unnamed: Q7.1 (C), R31.1
unnamed: Q8.1 (C), R32.2

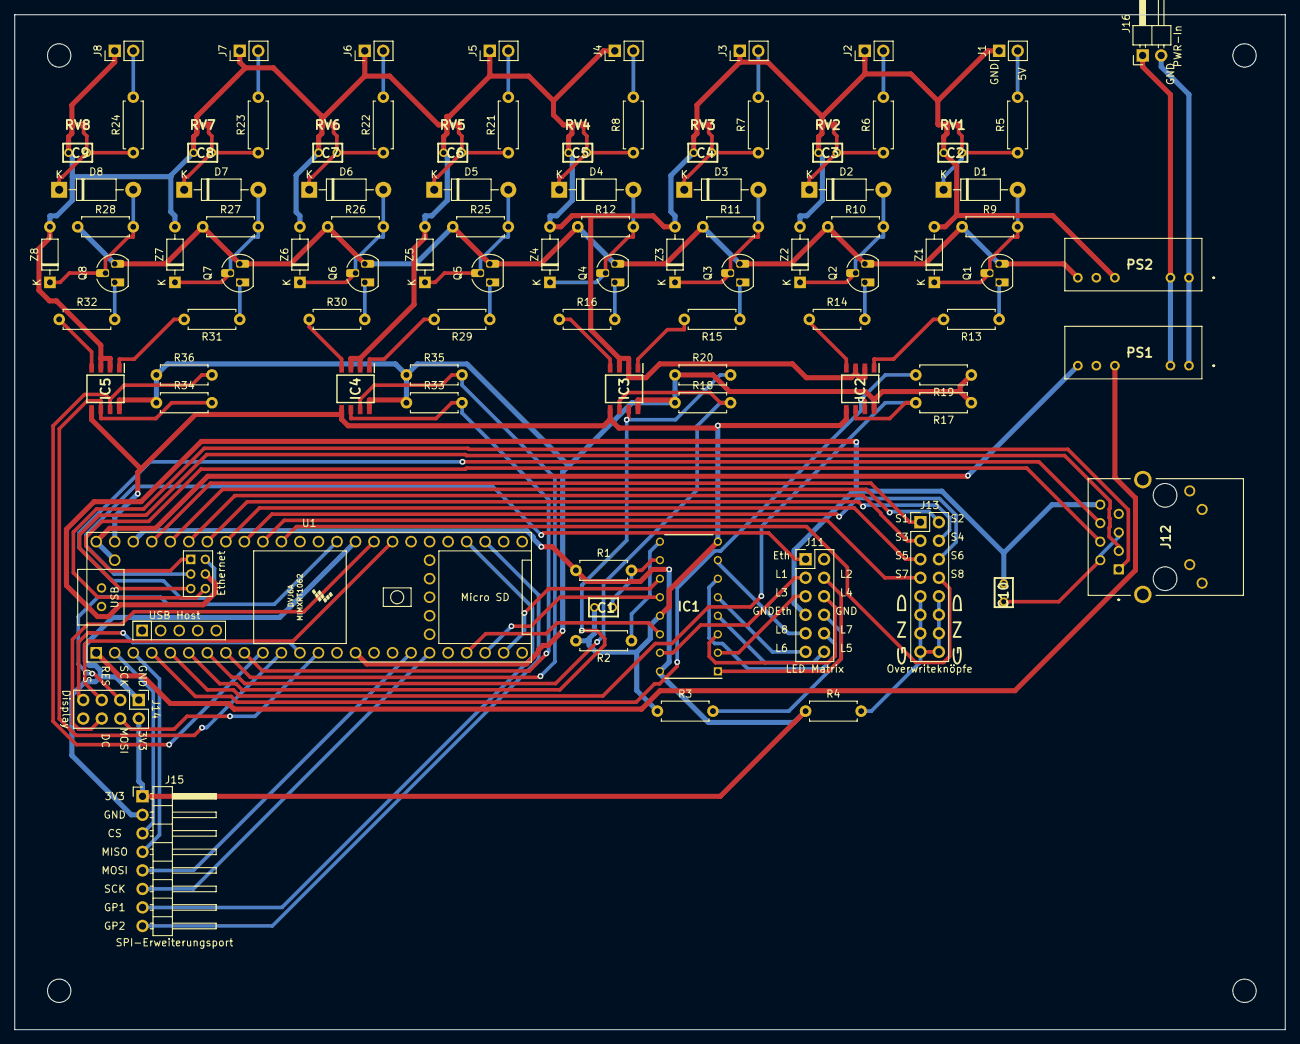
[picture p44: board Sender.kicad_pcb from above]

Board: 2 copper layers, 174.2 x 139.2 mm, 104 parts (0 on the bottom side), 99 nets.

Other parts of the board:
Moun4: MountingHole_3.2mm_M3
Mount1, Mount2, Mount3: MountingHole_3.2mm_M3
