GreenVaildSig/TallyNet_v1/Hardware/Empfaenger/Empfaenger.kicad_pcb

## KiCad design Hardware/Empfaenger/Empfaenger.kicad_pcb (2022-08-05)

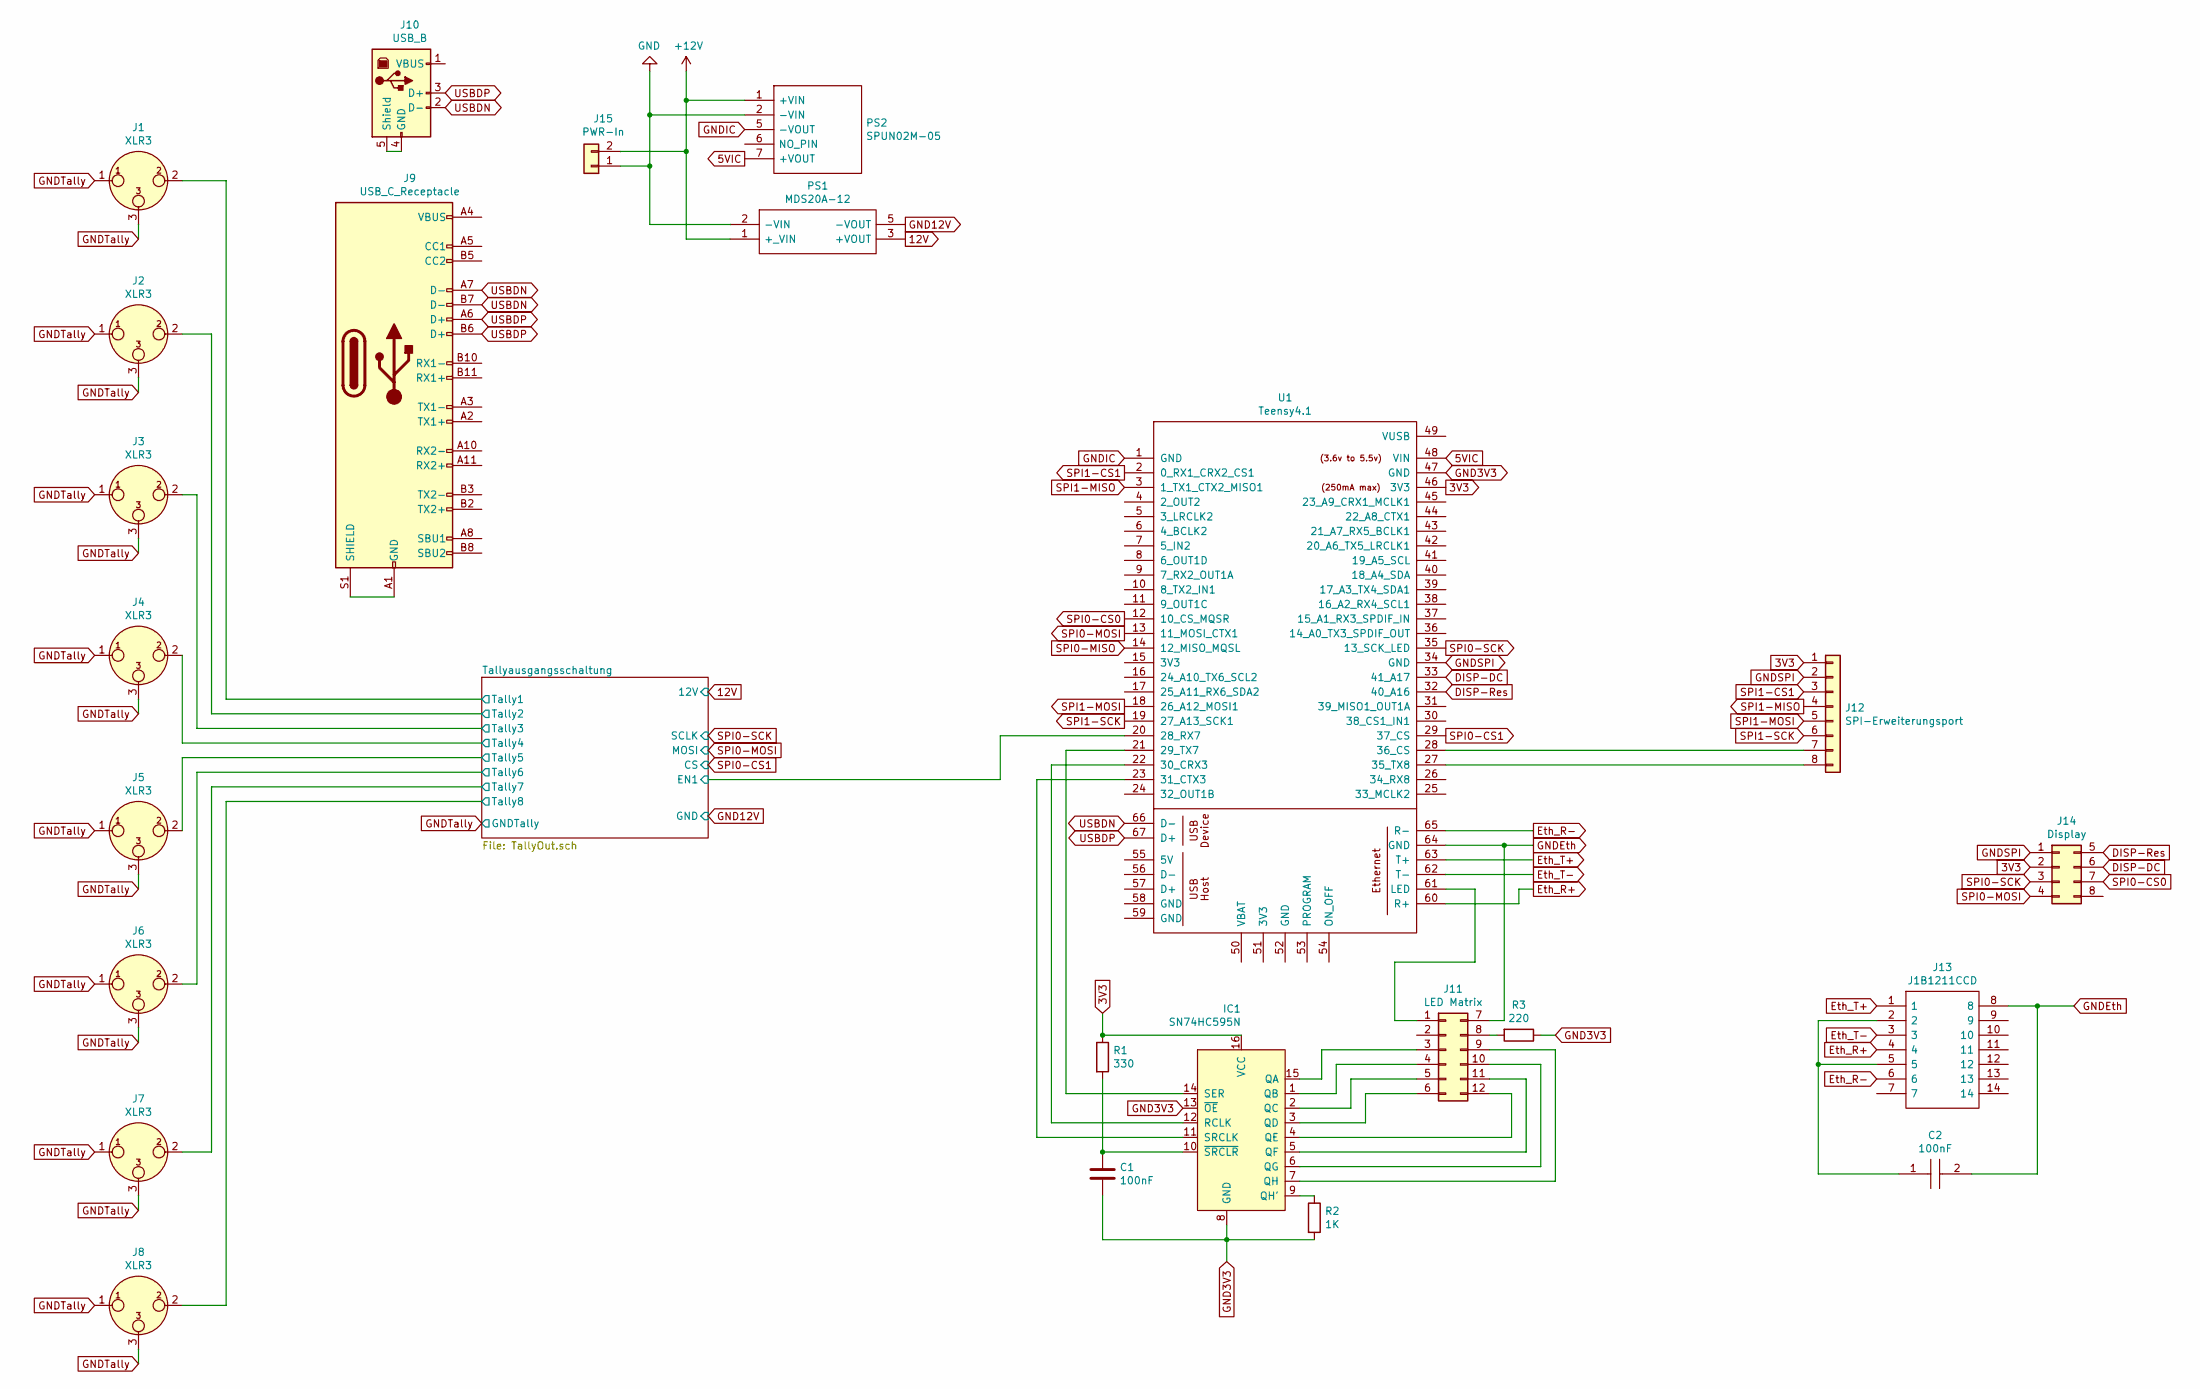
[picture p45: schematic Empfaenger.sch, Multi-Tally-Empfänger]

Parts:
C1: 100nF; MONO-KAP_SIZE-15-L-5_
C2: 100nF; MONO-KAP_SIZE-15-L-5_; Mouser Part Number 594-K104K15X7RF5TL2
IC1: SN74HC595N; DIP794W53P254L1930H508Q16N; Mouser Part Number 595-SN74HC595N
J1, J2, J3, J4, J5, J6, J7, J8: XLR3; PinHeader_1x02_P2.54mm_Vertical
J9: USB_C_Receptacle
J10: USB_B
J11: LED Matrix; PinHeader_2x06_P2.54mm_Vertical
J12: SPI-Erweiterungsport; PinHeader_1x08_P2.54mm_Horizontal
J13: J1B1211CCD; Mouser Part Number 950-J1B1211CCD
J14: Display; PinHeader_2x04_P2.54mm_Vertical
J15: PWR-In; PinHeader_1x02_P2.54mm_Horizontal
PS1: MDS20A-12; MDS20A12; Mouser Part Number 709-MDS20A-12
PS2: SPUN02M-05; SPUN02M05; Mouser Part Number 709-SPUN02M-05
R1: 330; R_Axial_DIN0207_L6.3mm_D2.5mm_P7.62mm_Horizontal
R2: 1K; R_Axial_DIN0207_L6.3mm_D2.5mm_P7.62mm_Horizontal
R3: 220; R_Axial_DIN0207_L6.3mm_D2.5mm_P7.62mm_Horizontal
U1: Teensy4.1; Teensy41

Connections:
3V3: IC1.16 (VCC), J12.1, J14.2, R1.1, U1.46 (3V3)
5VIC: PS2.7 (+VOUT), U1.48 (VIN), U1.49 (VUSB)
12V: PS1.3 (+VOUT); also elsewhere on the board
+12V: J15.2, PS1.1 (+_VIN), PS2.1 (+VIN)
/Tallyausgangsschaltung/EN1: U1.20 (28_RX7); also elsewhere on the board
/Tallyausgangsschaltung/Tally1: J1.2; also elsewhere on the board
/Tallyausgangsschaltung/Tally2: J2.2; also elsewhere on the board
/Tallyausgangsschaltung/Tally3: J3.2; also elsewhere on the board
/Tallyausgangsschaltung/Tally4: J4.2; also elsewhere on the board
/Tallyausgangsschaltung/Tally5: J5.2; also elsewhere on the board
/Tallyausgangsschaltung/Tally6: J6.2; also elsewhere on the board
/Tallyausgangsschaltung/Tally7: J7.2; also elsewhere on the board
/Tallyausgangsschaltung/Tally8: J8.2; also elsewhere on the board
DISP-DC: J14.6, U1.33 (41_A17)
DISP-Res: J14.5, U1.32 (40_A16)
Eth_R+: J13.4, U1.60 (R+)
Eth_R-: J13.6, U1.65 (R-)
Eth_T+: J13.1, U1.63 (T+)
Eth_T-: J13.3, U1.62 (T-)
GND: J15.1, PS1.2 (-VIN), PS2.2 (-VIN)
GND3V3: C1.2, IC1.8 (GND), IC1.13 (~OE), R2.2, R3.1, U1.47 (GND)
GND12V: PS1.5 (-VOUT); also elsewhere on the board
GNDEth: C2.2, J11.7, J13.8, U1.64 (GND)
GNDIC: PS2.5 (-VOUT), U1.1 (GND)
GNDSPI: J12.2, J14.1, U1.34 (GND)
GNDTally: J1.1, J1.3, J2.1, J2.3, J3.1, J3.3, J4.1, J4.3, J5.1, J5.3, J6.1, J6.3, J7.1, J7.3, J8.1, J8.3; also elsewhere on the board
unnamed: C1.1, IC1.10 (~SRCLR), R1.2
unnamed: C2.1, J13.2, J13.5
unnamed: IC1.1 (QB), J11.4
unnamed: IC1.2 (QC), J11.5
unnamed: IC1.3 (QD), J11.6
unnamed: IC1.4 (QE), J11.12
unnamed: IC1.5 (QF), J11.11
unnamed: IC1.6 (QG), J11.10
unnamed: IC1.7 (QH), J11.9
unnamed: IC1.9 (QH'), R2.1
unnamed: IC1.11 (SRCLK), U1.23 (31_CTX3)
unnamed: IC1.12 (RCLK), U1.22 (30_CRX3)
unnamed: IC1.14 (SER), U1.21 (29_TX7)
unnamed: IC1.15 (QA), J11.3
unnamed: J9.A1 (GND), J9.A12 (GND), J9.B1 (GND), J9.B12 (GND), J9.S1 (SHIELD)
unnamed: J9.A4 (VBUS), J9.A9 (VBUS), J9.B4 (VBUS), J9.B9 (VBUS)
unnamed: J10.4 (GND), J10.5 (Shield)
unnamed: J11.1, U1.61 (LED)
unnamed: J11.8, R3.2
unnamed: J12.7, U1.28 (36_CS)
unnamed: J12.8, U1.27 (35_TX8)
SPI0-CS0: J14.7, U1.12 (10_CS_MQSR)
SPI0-CS1: U1.29 (37_CS); also elsewhere on the board
SPI0-MISO: U1.14 (12_MISO_MQSL)
SPI0-MOSI: J14.4, U1.13 (11_MOSI_CTX1); also elsewhere on the board
SPI0-SCK: J14.3, U1.35 (13_SCK_LED); also elsewhere on the board
SPI1-CS1: J12.3, U1.2 (0_RX1_CRX2_CS1)
SPI1-MISO: J12.4, U1.3 (1_TX1_CTX2_MISO1)
SPI1-MOSI: J12.5, U1.18 (26_A12_MOSI1)
SPI1-SCK: J12.6, U1.19 (27_A13_SCK1)
USBDN: J9.A7 (D-), J9.B7 (D-), J10.2 (D-), U1.66 (D-)
USBDP: J9.A6 (D+), J9.B6 (D+), J10.3 (D+), U1.67 (D+)

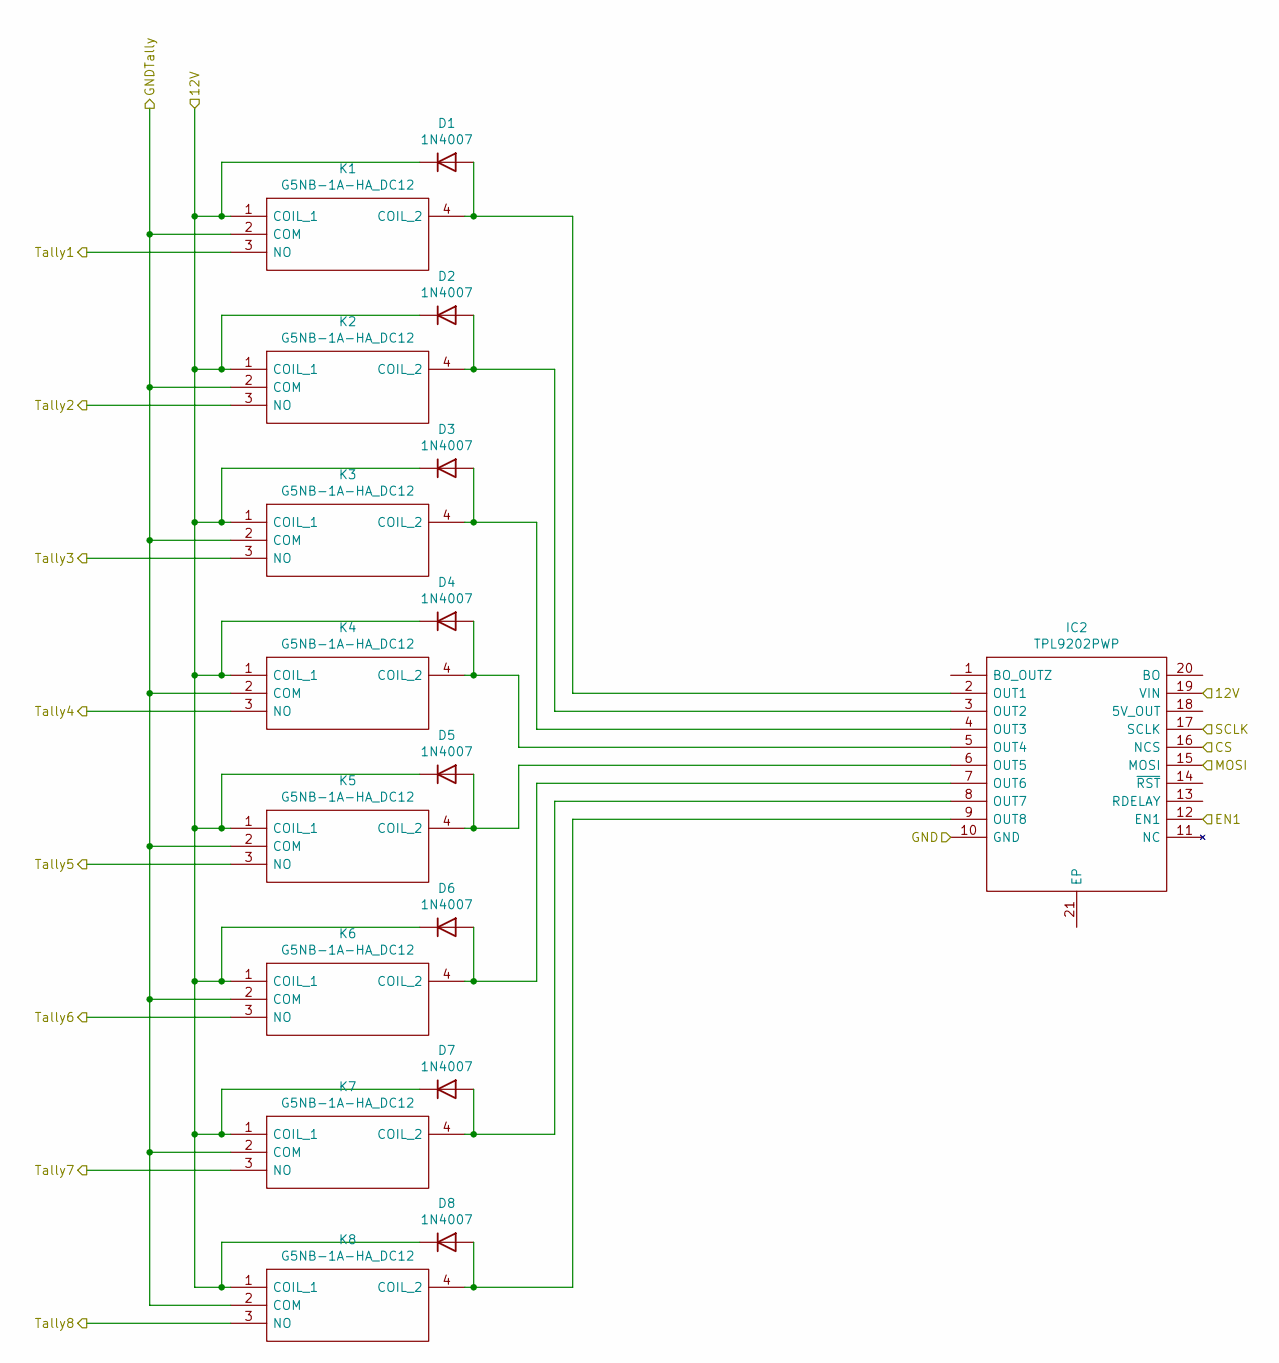
[picture p46: schematic TallyOut.sch, Tallyausgangsschaltung]

Parts:
D1, D2, D3, D4, D5, D6, D7, D8: 1N4007; D_DO-41_SOD81_P10.16mm_Horizontal
IC2: TPL9202PWP; SOP65P640X120-21N; Mouser Part Number 595-TPL9202PWP
K1, K2, K3, K4, K5, K6, K7, K8: G5NB-1A-HA_DC12; G5NB1AHADC12; Mouser Part Number 653-G5NB-1A-HADC12

Connections:
12V: D1.1 (K), D2.1 (K), D3.1 (K), D4.1 (K), D5.1 (K), D6.1 (K), D7.1 (K), D8.1 (K), IC2.19 (VIN), K1.1 (COIL_1), K2.1 (COIL_1), K3.1 (COIL_1), K4.1 (COIL_1), K5.1 (COIL_1), K6.1 (COIL_1), K7.1 (COIL_1), K8.1 (COIL_1); also elsewhere on the board
/Tallyausgangsschaltung/EN1: IC2.12 (EN1); also elsewhere on the board
/Tallyausgangsschaltung/Tally1: K1.3 (NO); also elsewhere on the board
/Tallyausgangsschaltung/Tally2: K2.3 (NO); also elsewhere on the board
/Tallyausgangsschaltung/Tally3: K3.3 (NO); also elsewhere on the board
/Tallyausgangsschaltung/Tally4: K4.3 (NO); also elsewhere on the board
/Tallyausgangsschaltung/Tally5: K5.3 (NO); also elsewhere on the board
/Tallyausgangsschaltung/Tally6: K6.3 (NO); also elsewhere on the board
/Tallyausgangsschaltung/Tally7: K7.3 (NO); also elsewhere on the board
/Tallyausgangsschaltung/Tally8: K8.3 (NO); also elsewhere on the board
GND12V: IC2.10 (GND); also elsewhere on the board
GNDTally: K1.2 (COM), K2.2 (COM), K3.2 (COM), K4.2 (COM), K5.2 (COM), K6.2 (COM), K7.2 (COM), K8.2 (COM); also elsewhere on the board
unnamed: D1.2 (A), IC2.2 (OUT1), K1.4 (COIL_2)
unnamed: D2.2 (A), IC2.3 (OUT2), K2.4 (COIL_2)
unnamed: D3.2 (A), IC2.4 (OUT3), K3.4 (COIL_2)
unnamed: D4.2 (A), IC2.5 (OUT4), K4.4 (COIL_2)
unnamed: D5.2 (A), IC2.6 (OUT5), K5.4 (COIL_2)
unnamed: D6.2 (A), IC2.7 (OUT6), K6.4 (COIL_2)
unnamed: D7.2 (A), IC2.8 (OUT7), K7.4 (COIL_2)
unnamed: D8.2 (A), IC2.9 (OUT8), K8.4 (COIL_2)
SPI0-CS1: IC2.16 (NCS); also elsewhere on the board
SPI0-MOSI: IC2.15 (MOSI); also elsewhere on the board
SPI0-SCK: IC2.17 (SCLK); also elsewhere on the board

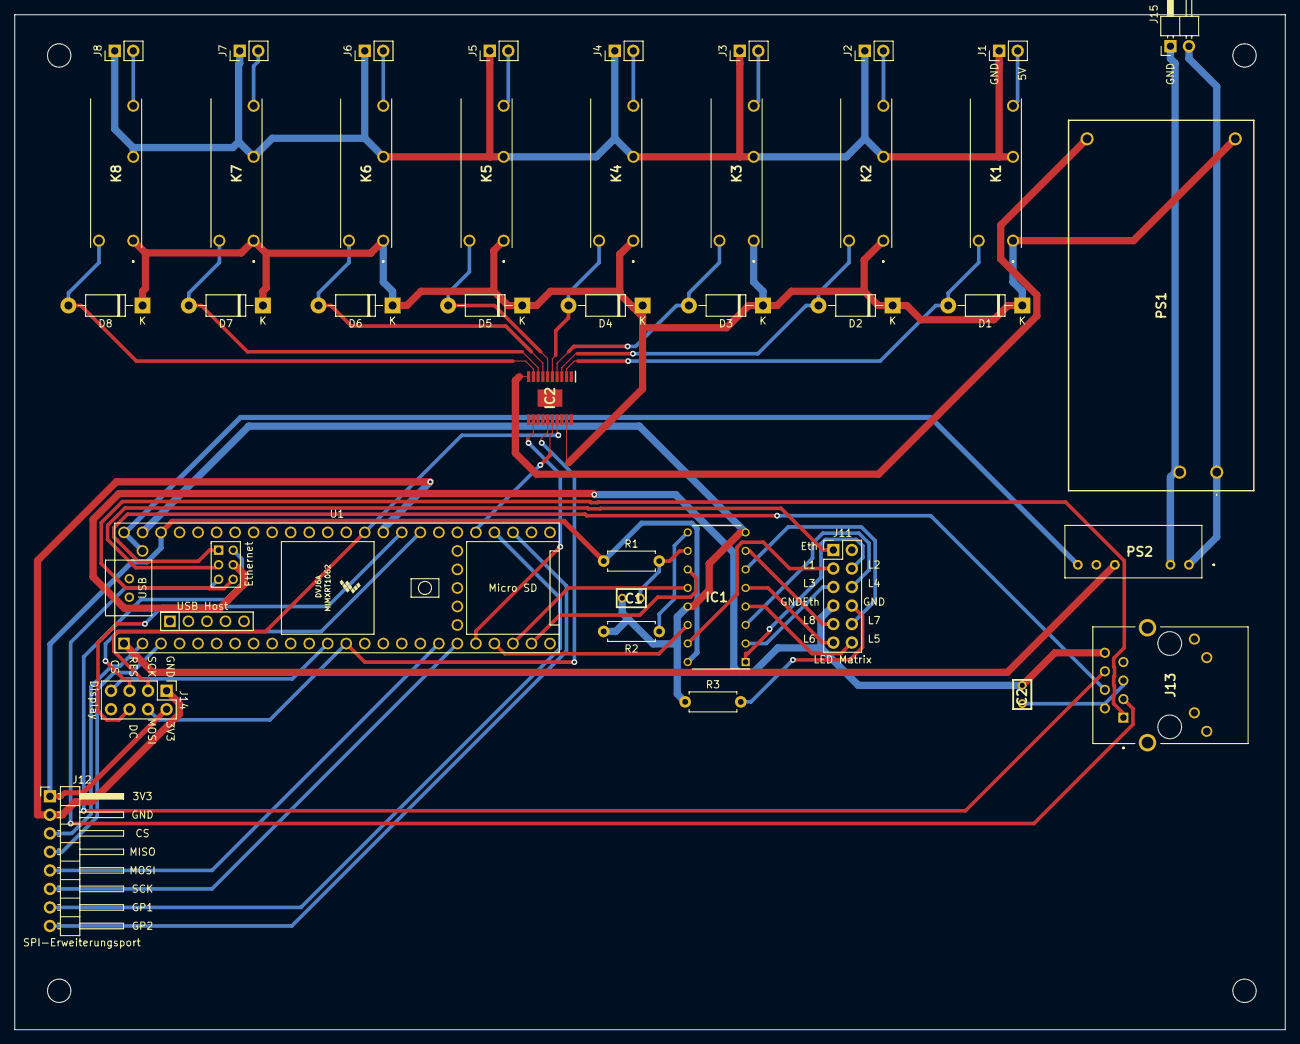
[picture p47: board Empfaenger.kicad_pcb from above]

Board: 2 copper layers, 174.2 x 139.2 mm, 43 parts (0 on the bottom side), 60 nets.

Other parts of the board:
Moun4: MountingHole_3.2mm_M3
Mount1, Mount2, Mount3: MountingHole_3.2mm_M3
