GreenVaildSig/TallyNet_v1/(commit log)

2022-08-05 Dokumentation und Anlagen hinzugefügt
2022-08-05 Gehäuse Daten
    [#Back.dxf, #DeMuxFront.dxf, #MuxFront.dxf, Back.dxf, DeMuxFront.dxf, MuxFront.dxf, nc3fdm3-l-1-4.dxf, ne8fdy-c6-4.dxf]
2022-08-05 Software v1
    [Protokoll.xlsx]
2022-08-05 KiCAD Dateien
    [Empfaenger.kicad_pcb, Empfaenger.sch, Sender.kicad_pcb, Sender.sch, TallyIn.sch, TallyOut.sch]
